teunrensing/APPS/hardware/Testapparaat/74HC14D,653.stp

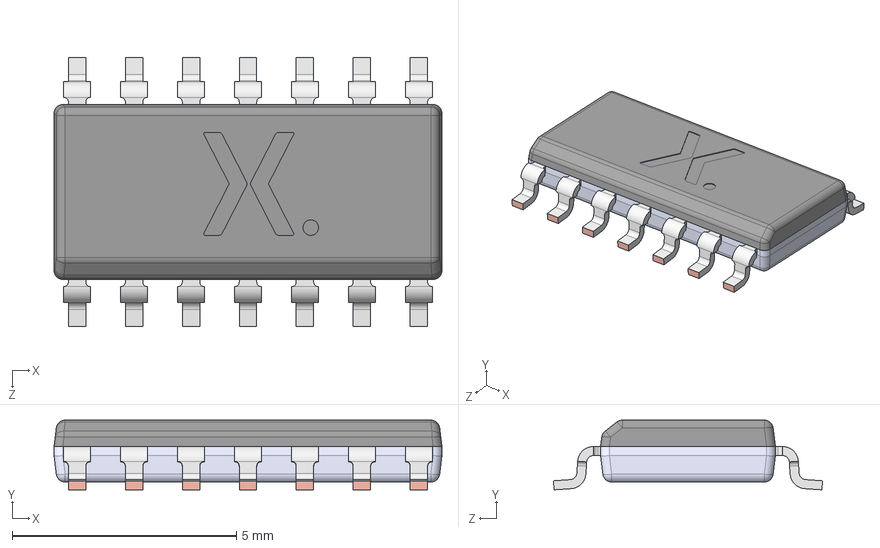
[picture p1: CAD file, 2022-11-10]
hardware/Testapparaat/74HC14D,653.stp
8.65 x 1.56 x 6.00 mm
SOT108 lower body
SOT108 upper body
SOT108-1 Lead
