teunrensing/APPS/hardware/Testapparaat/74HC595D-Q100,118/74HC595D-Q100,118.stp

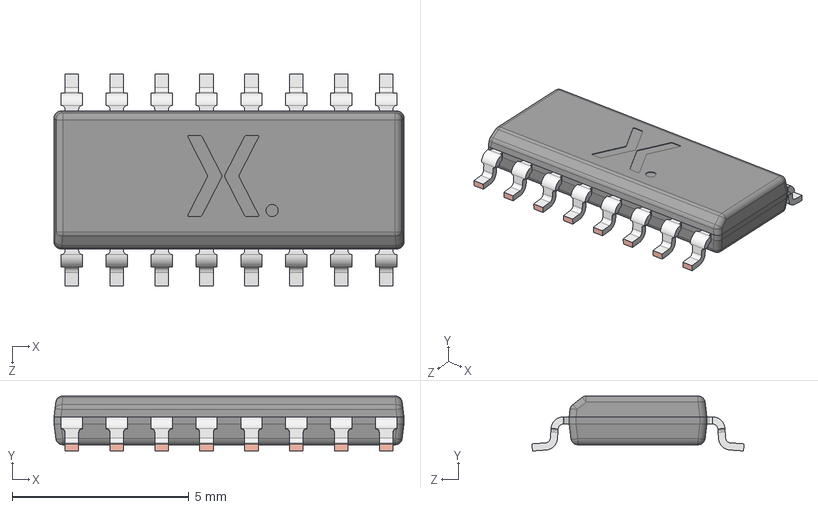
[picture p2: CAD file, 2022-11-10]
hardware/Testapparaat/74HC595D-Q100,118/74HC595D-Q100,118.stp
9.90 x 1.56 x 6.00 mm
SOT109-1 lower body
SOT109-1 upper body
SOT109-1 Lead
