teunrensing/APPS/hardware/Testapparaat/Barrel_Jack/CON-SOCJ-2155.step

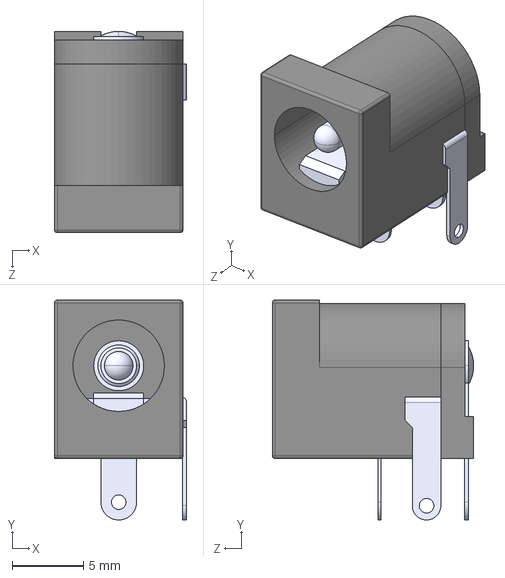
[picture p3: CAD file, 2022-10-18]
hardware/Testapparaat/Barrel_Jack/CON-SOCJ-2155.step
9.25 x 15.4 x 14.1 mm
