teunrensing/APPS/hardware/Testapparaat/F32Q-1A7H1-11040/3D/F32Q-1A7H1-11040.stp

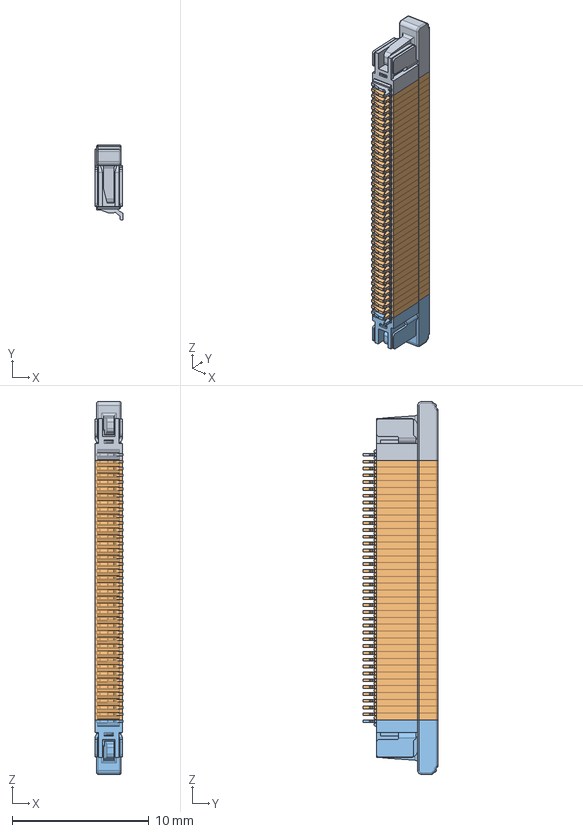
[picture p4: CAD file, 2022-11-10]
hardware/Testapparaat/F32Q-1A7H1-11040/3D/F32Q-1A7H1-11040.stp
2.05 x 5.50 x 27.3 mm
F32Q_L
F32Q_M x 38
F32Q_R
