teunrensing/APPS/hardware/Testapparaat/G17C0900132EU/D-Sub 6180xx211821.stp

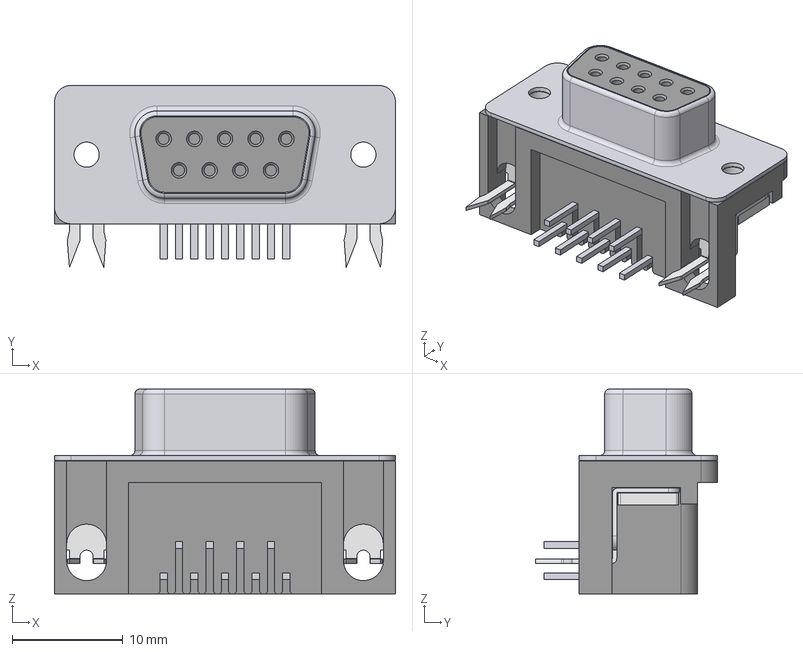
[picture p5: CAD file, 2022-10-18]
hardware/Testapparaat/G17C0900132EU/D-Sub 6180xx211821.stp
30.8 x 16.5 x 18.5 mm
