teunrensing/APPS/hardware/Testapparaat/MEM2051-00-195-00-A/MEM2051-00-195-00-A.stp

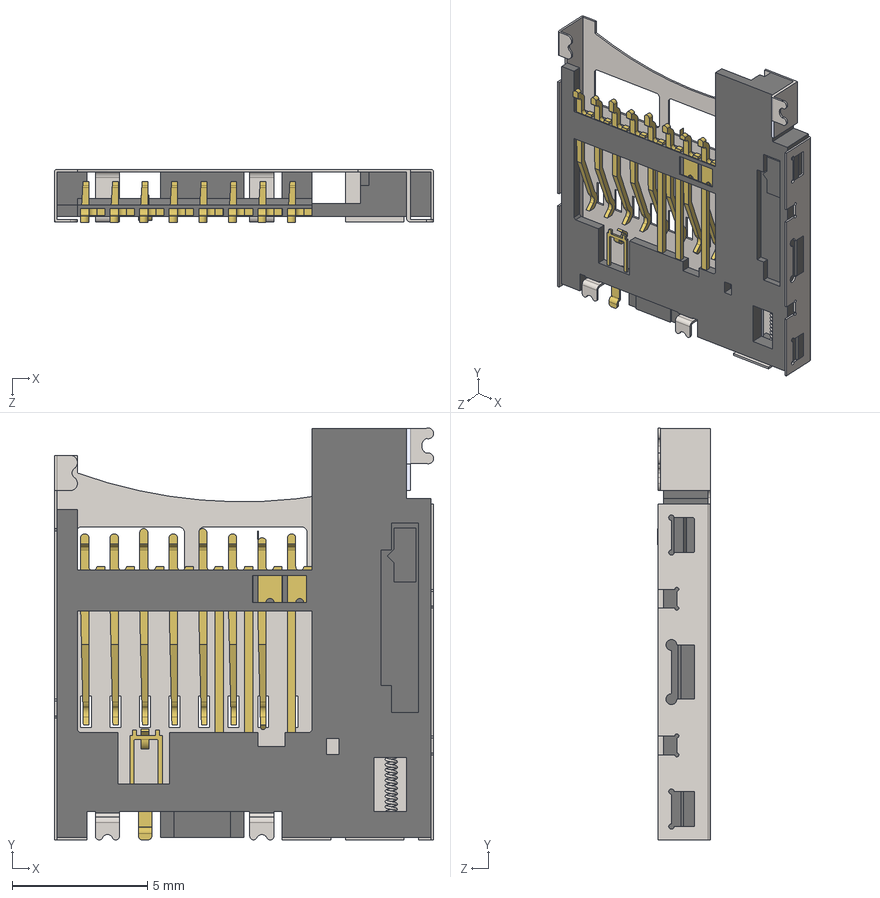
[picture p6: CAD file, 2022-10-18]
hardware/Testapparaat/MEM2051-00-195-00-A/MEM2051-00-195-00-A.stp
14.0 x 15.2 x 1.97 mm
