teunrensing/APPS/hardware/Testapparaat/SN74AHC1G02DRLR/SN74AHC1G02DRLR.stp

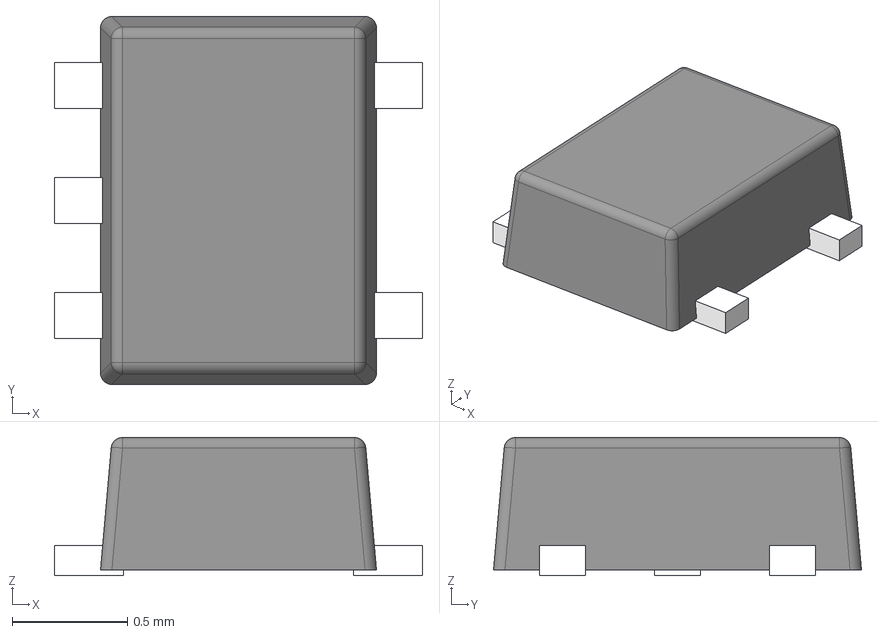
[picture p7: CAD file, 2022-10-18]
hardware/Testapparaat/SN74AHC1G02DRLR/SN74AHC1G02DRLR.stp
1.60 x 1.60 x 0.6 mm
FRAME-DRL0005A
BODY-SOT
PIN1-ID
