teunrensing/APPS/hardware/Testapparaat/SRR1260/srr1260.stp

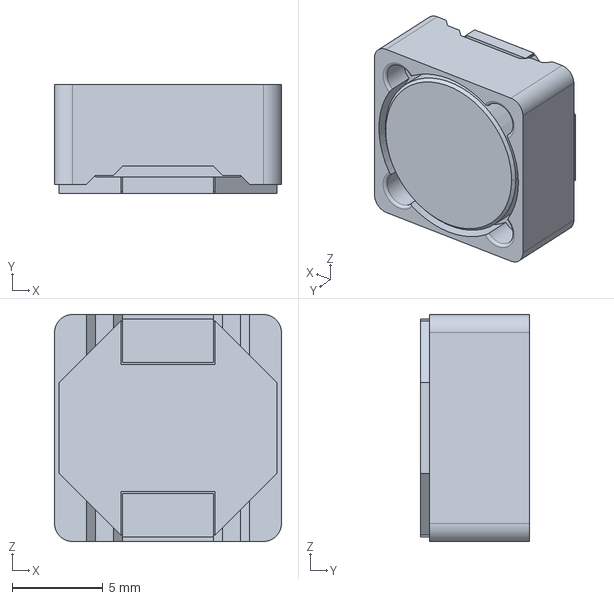
[picture p8: CAD file, 2022-11-10]
hardware/Testapparaat/SRR1260/srr1260.stp
12.5 x 6.00 x 12.5 mm
