teunrensing/APPS/hardware/Testapparaat/TCA9534PWR/TCA9534PWR.stp

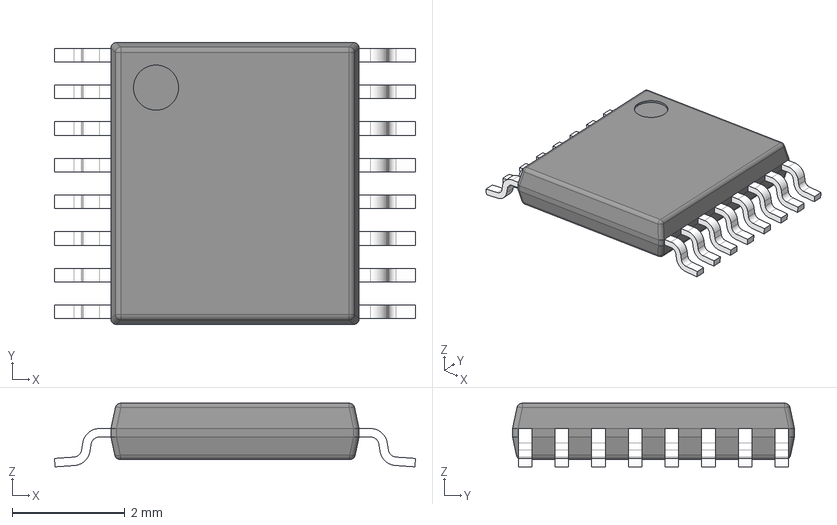
[picture p9: CAD file, 2022-11-10]
hardware/Testapparaat/TCA9534PWR/TCA9534PWR.stp
6.40 x 5.00 x 1.13 mm
BODY-TSSOP
LEAD-TSSOP x 16
PIN1
