teunrensing/APPS/hardware/Schematic/Testapparaat.pdf

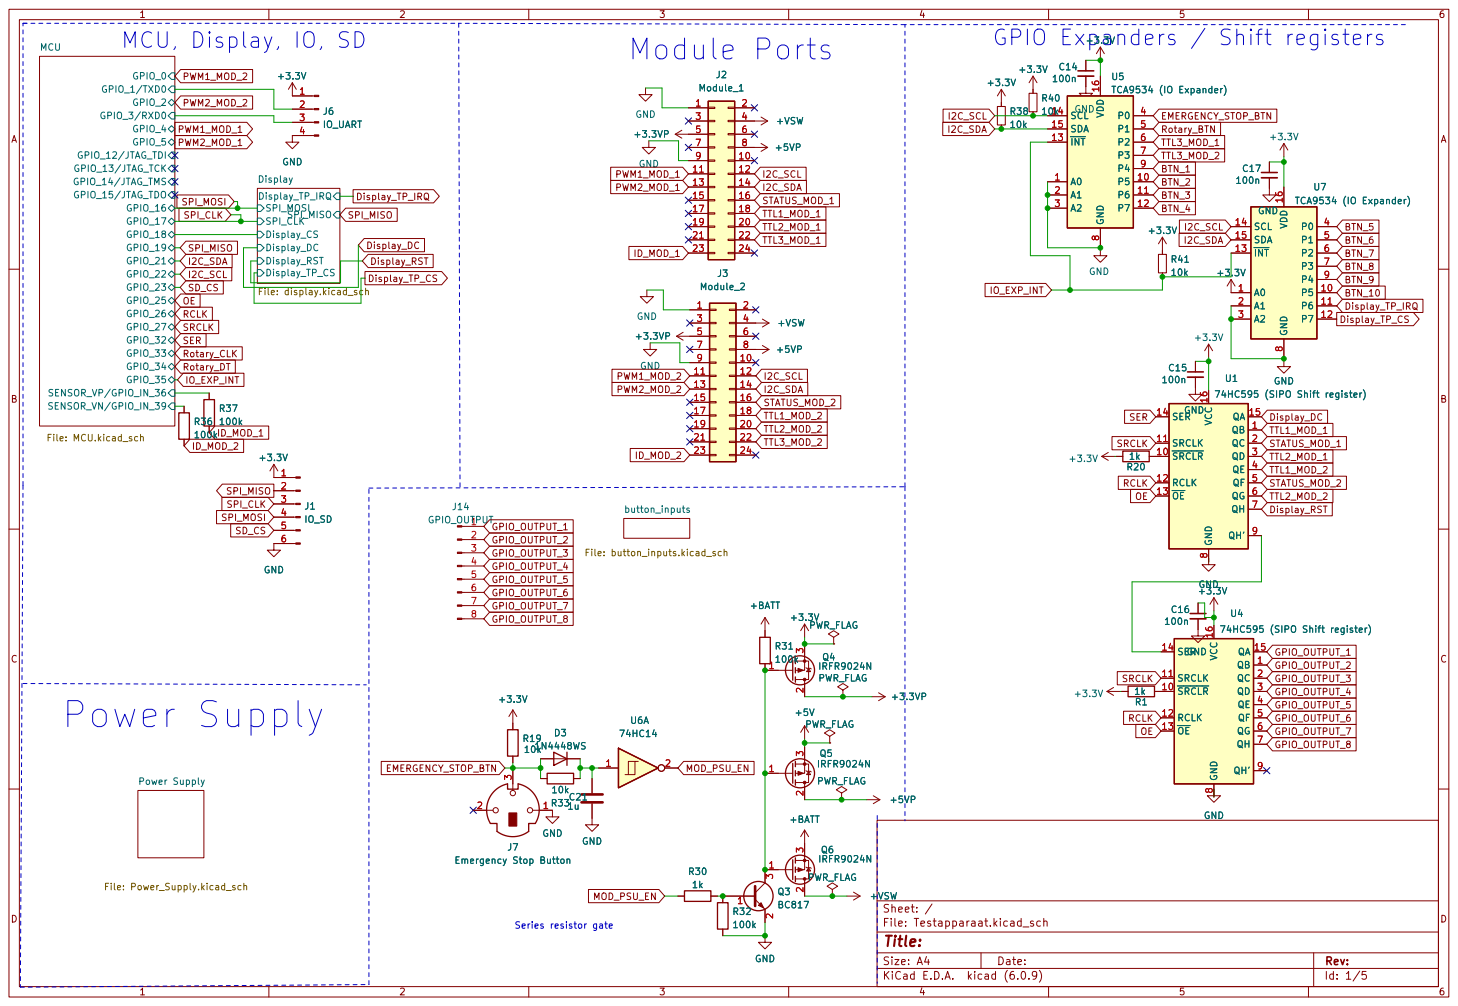
[picture p10: page 1]

GPIO Expanders / Shift registers

8 P4 9 U7 TCA9534 (IO Expander) GND GND

74HC595 (SIPO Shift register) GND

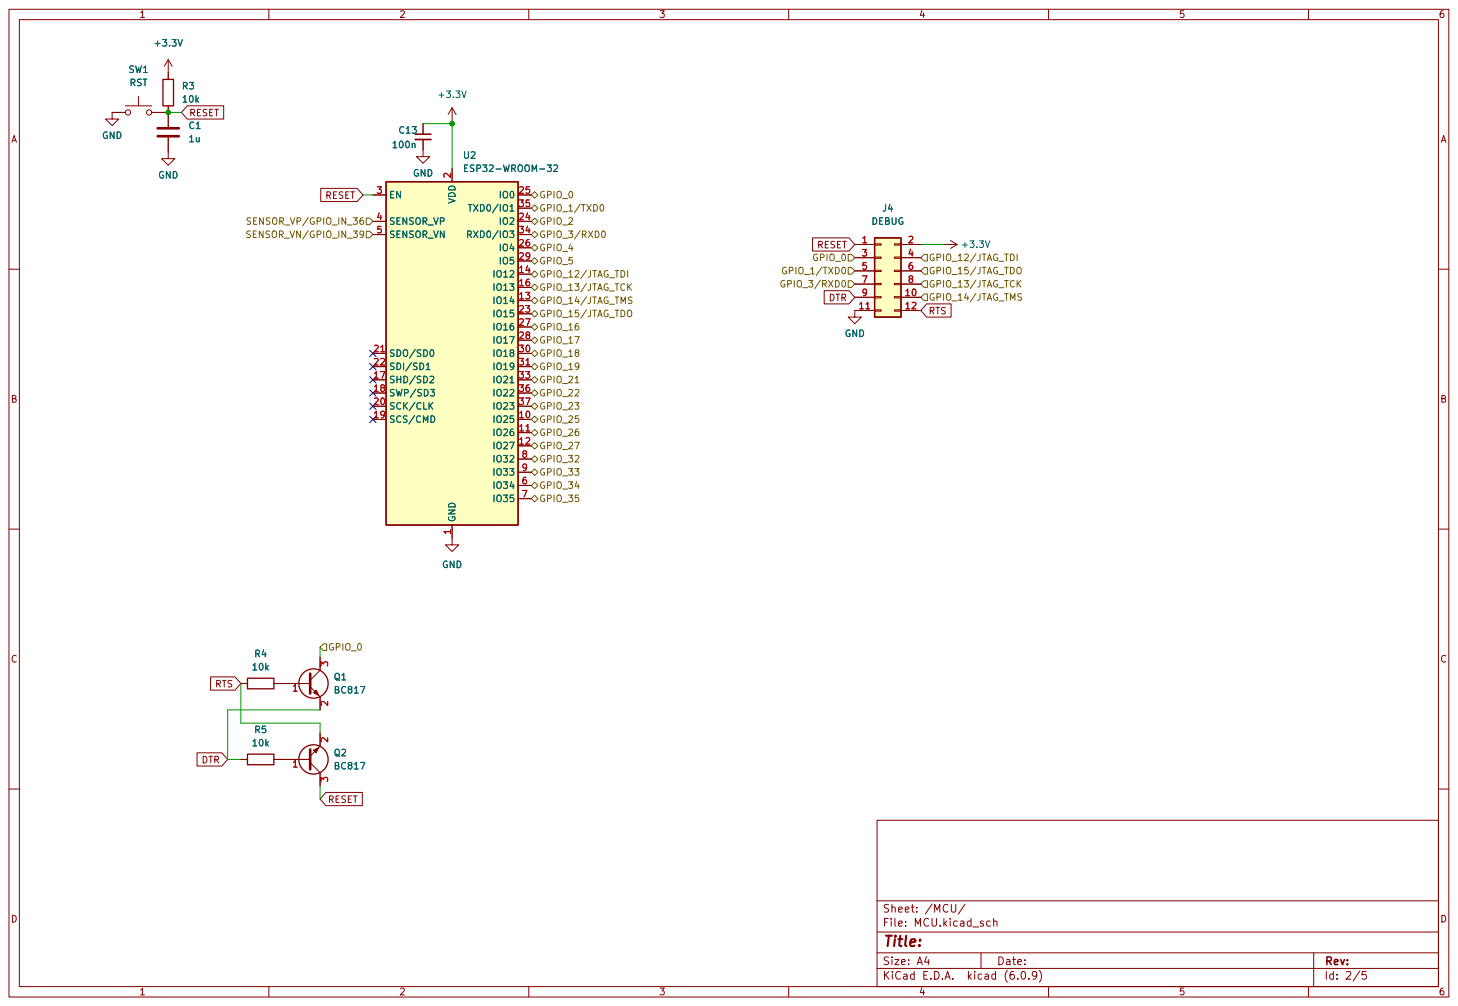
[picture p11: page 2]

RTS RESET RESETRTS DTR

File: MCU.kicad_sch Sheet: /MCU/

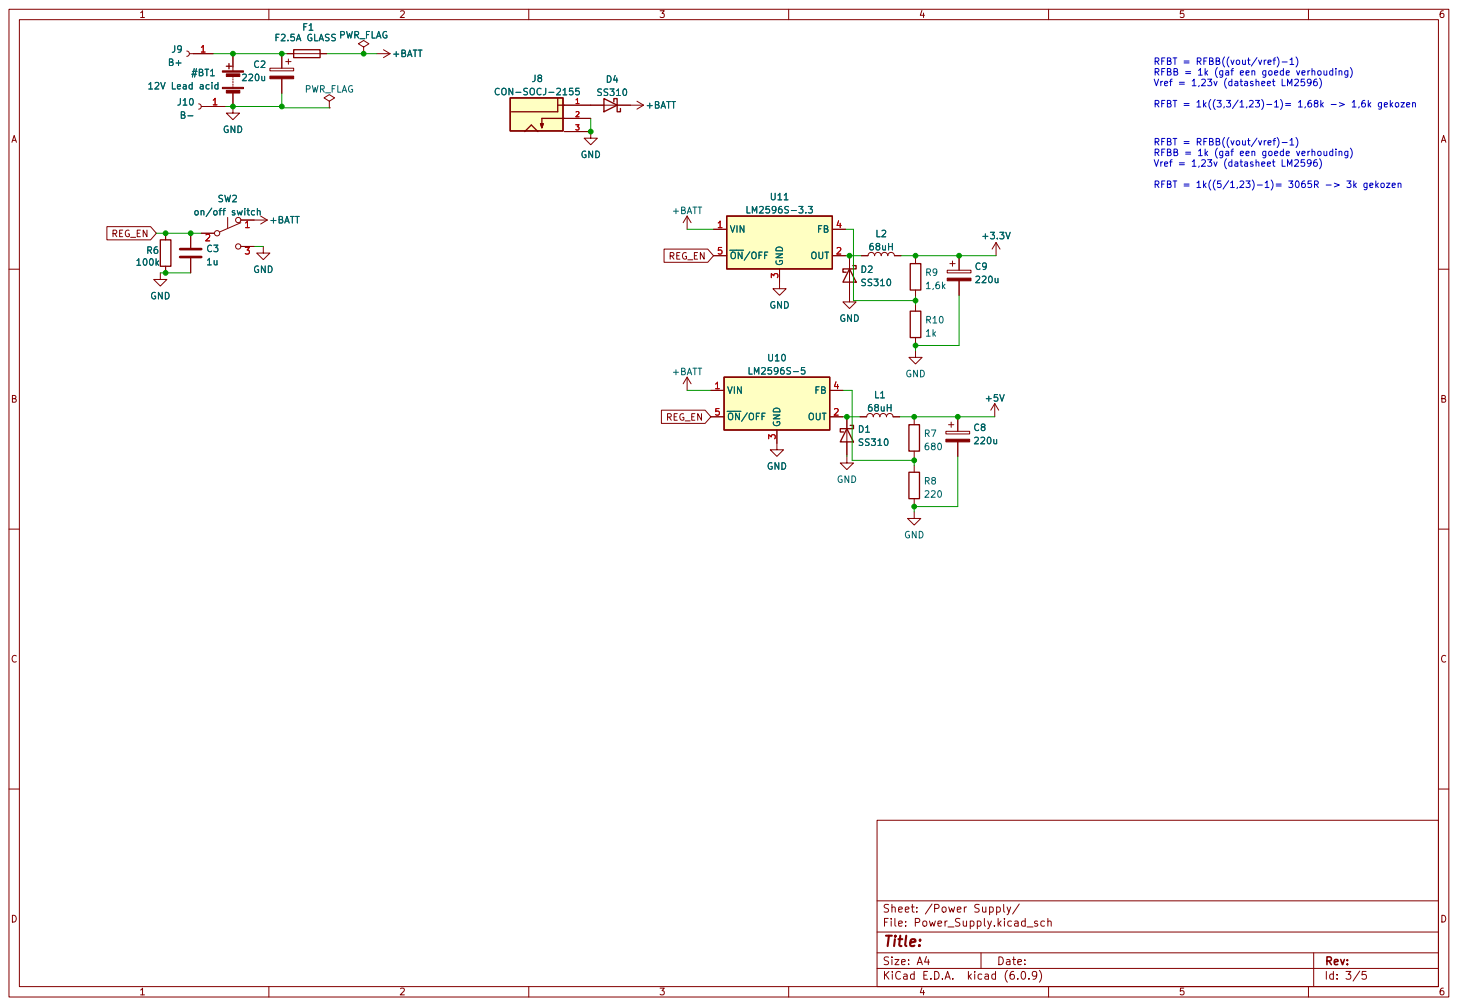
[picture p12: page 3]

RFBT = RFBB((vout/vref)-1)
RFBB = 1k (gaf een goede verhouding)
Vref = 1,23v (datasheet LM2596)

on/off switch GND

3 FB 4 ~{ON}/OFF 5 GND

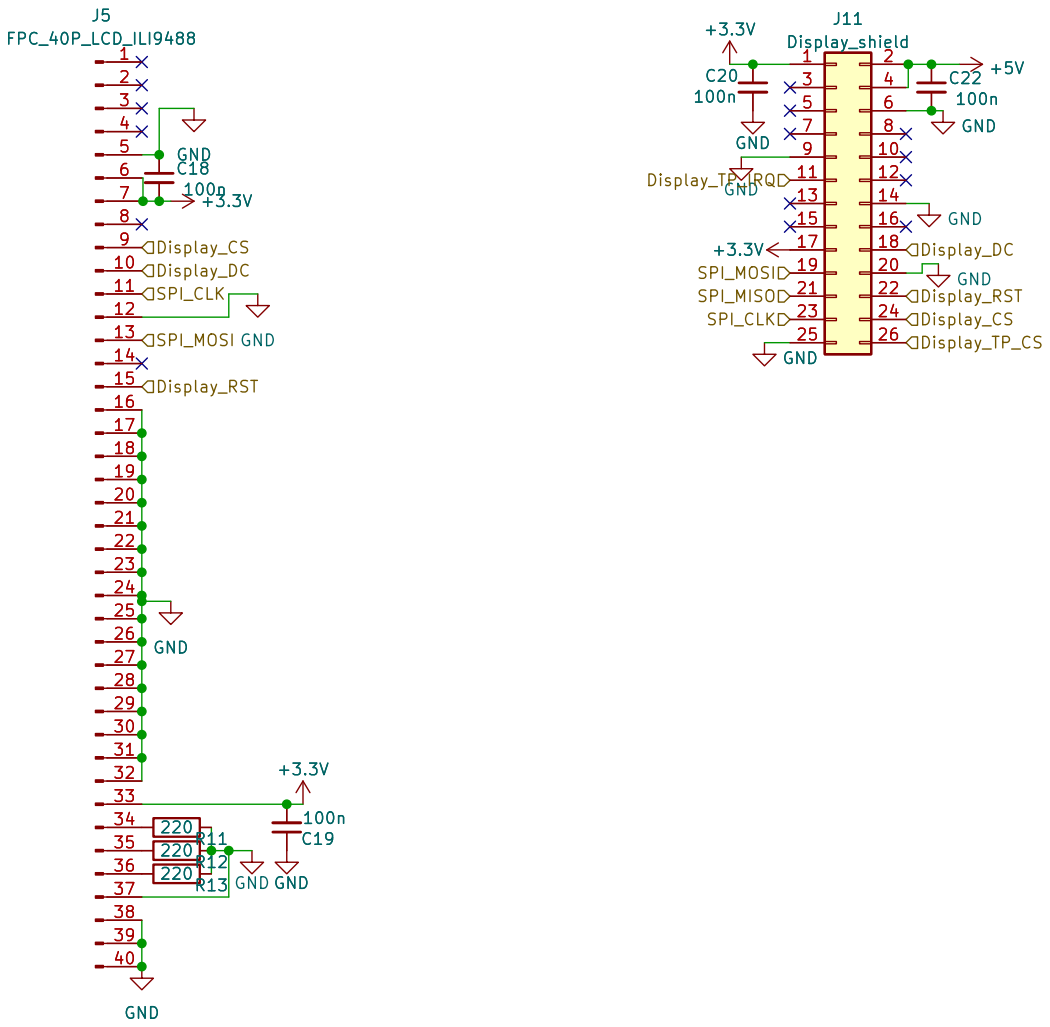
[picture p13: page 4]

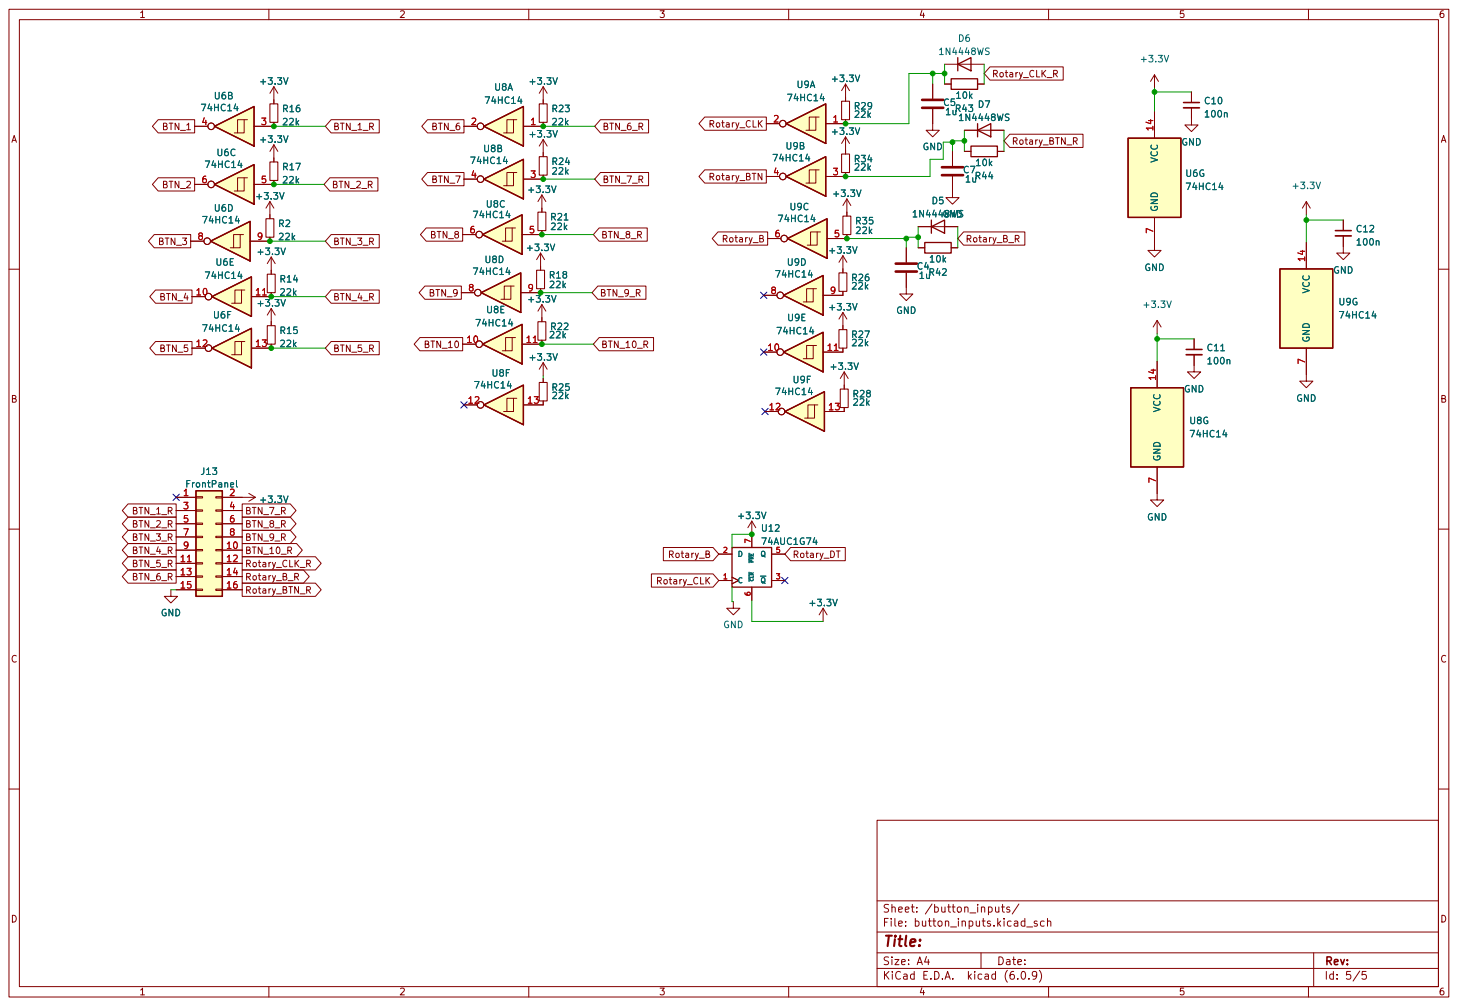
[picture p14: page 5]
