teunrensing/APPS/hardware/Testapparaat_IO/Testapparaat_io/Testapparaat_io.kicad_pcb

## KiCad design hardware/Testapparaat_IO/Testapparaat_io/Testapparaat_io.kicad_pcb (2022-11-22)

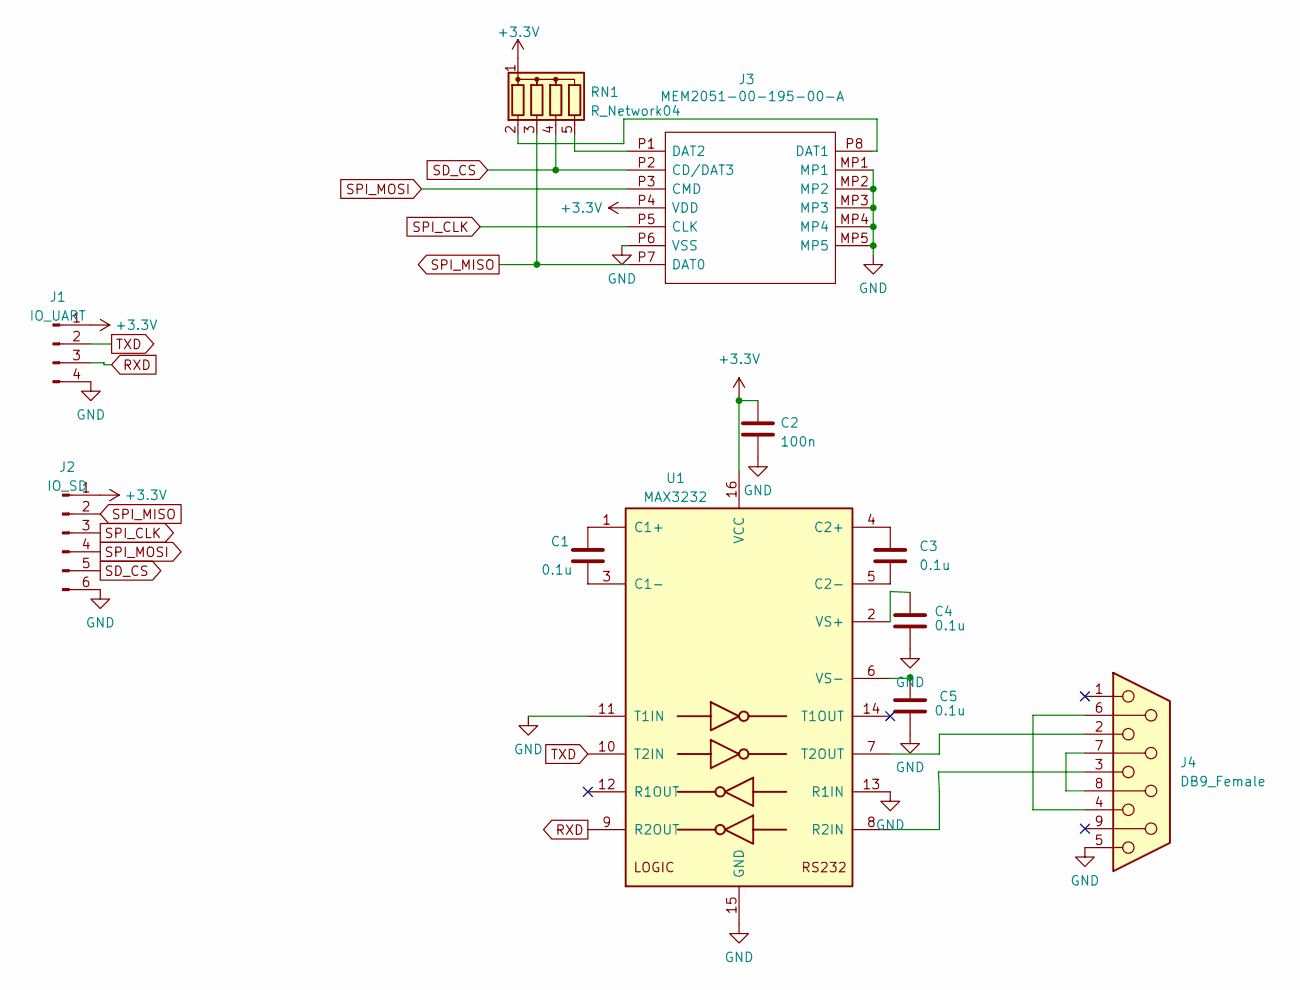
[picture p15: schematic Testapparaat_io.kicad_sch]

Parts:
C1, C3, C4, C5: 0.1u; C_0603_1608Metric_Pad1.08x0.95mm_HandSolder
C2: 100n; C_0603_1608Metric_Pad1.08x0.95mm_HandSolder
J1: IO_UART; PinHeader_1x04_P2.54mm_Horizontal
J2: IO_SD; PinHeader_1x06_P2.54mm_Horizontal
J3: MEM2051-00-195-00-A; MEM20510019500A; Manufacturer_Part_Number MEM2051-00-195-00-A; Mouser Part Number 640-MEM20510019500A
J4: DB9_Female; G17C0900132EU
RN1: R_Network04; R_Array_SIP5
U1: MAX3232; TSSOP-16_4.4x5mm_P0.65mm

Connections:
+3.3V: C2.1, J1.1, J2.1, J3.P4 (VDD), RN1.1 (common), U1.16 (VCC)
GND: C2.2, C4.1, C5.2, J1.4, J2.6, J3.MP1, J3.MP2, J3.MP3, J3.MP4, J3.MP5, J3.P6 (VSS), J4.5, U1.11 (T1IN), U1.13 (R1IN), U1.15 (GND)
unnamed: C1.1, U1.1 (C1+)
unnamed: C1.2, U1.3 (C1-)
unnamed: C3.1, U1.4 (C2+)
unnamed: C3.2, U1.5 (C2-)
unnamed: C4.2, U1.2 (VS+)
unnamed: C5.1, U1.6 (VS-)
unnamed: J3.P8 (DAT1), RN1.2 (R1)
unnamed: J4.2, U1.7 (T2OUT)
unnamed: J4.3, U1.8 (R2IN)
unnamed: J4.4, J4.6
unnamed: J4.7, J4.8
unnamed: J3.P1 (DAT2), RN1.5 (R4)
RXD: J1.3, U1.9 (R2OUT)
SD_CS: J2.5, J3.P2 (CD/DAT3), RN1.4 (R3)
SPI_CLK: J2.3, J3.P5 (CLK)
SPI_MISO: J2.2, J3.P7 (DAT0), RN1.3 (R2)
SPI_MOSI: J2.4, J3.P3 (CMD)
TXD: J1.2, U1.10 (T2IN)

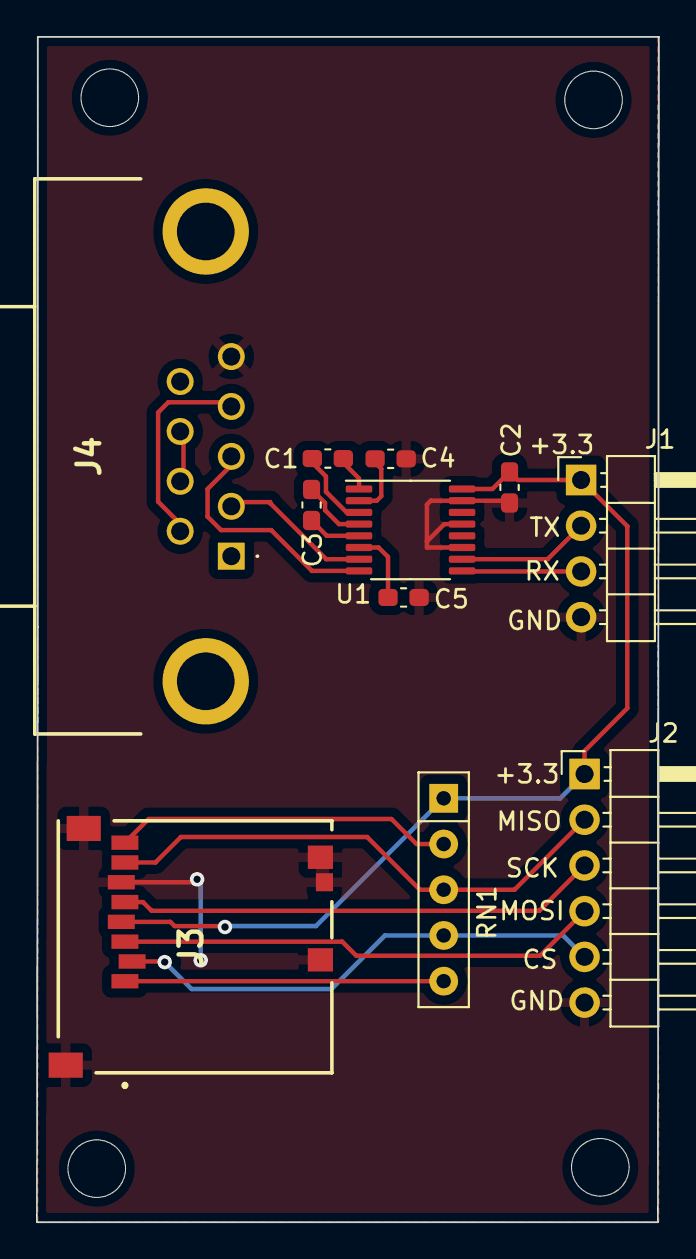
[picture p16: board Testapparaat_io.kicad_pcb from above]

Board: 2 copper layers, 34.5 x 65.8 mm, 11 parts (0 on the bottom side), 20 nets.
