teunrensing/APPS/hardware/Testapparaat/Testapparaat.kicad_pcb

## KiCad design hardware/Testapparaat/Testapparaat.kicad_pcb (2022-11-22)

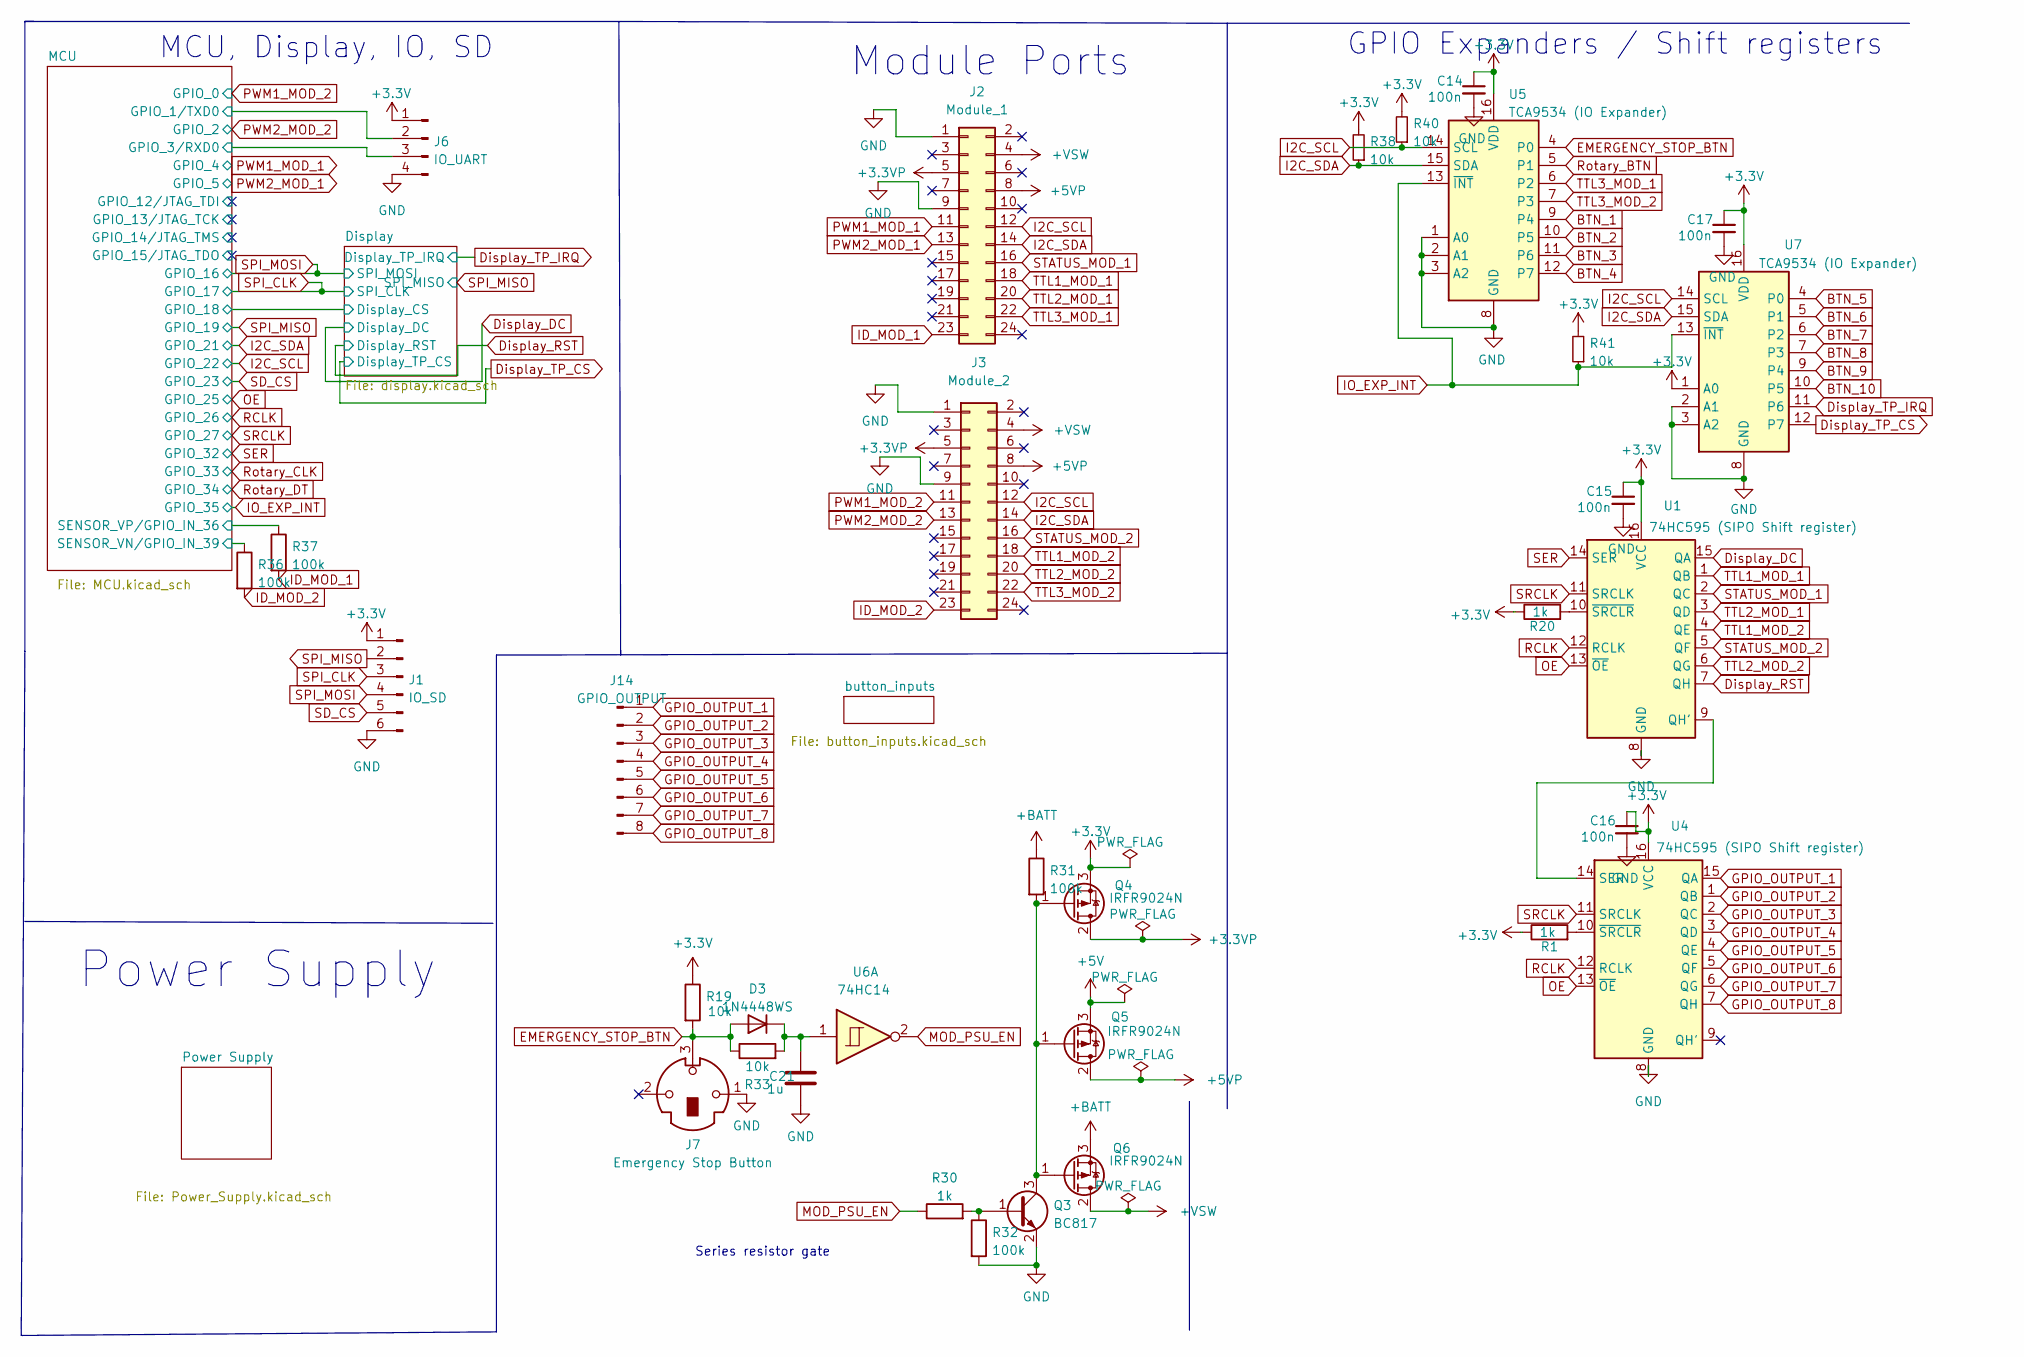
[picture p17: schematic Testapparaat.kicad_sch]

Parts:
C14, C15, C16, C17: 100n; C_0603_1608Metric_Pad1.08x0.95mm_HandSolder
C21: 1u; C_0603_1608Metric_Pad1.08x0.95mm_HandSolder
D3: 1N4448WS; D_SOD-323
J1: IO_SD; PinHeader_1x06_P2.54mm_Horizontal
J2: Module_1; PinHeader_2x12_P2.54mm_Horizontal
J3: Module_2; PinHeader_2x12_P2.54mm_Horizontal
J6: IO_UART; PinHeader_1x04_P2.54mm_Horizontal
J7: Emergency Stop Button; PinHeader_1x03_P2.54mm_Horizontal
J14: GPIO_OUTPUT; PinHeader_2x04_P2.54mm_Vertical_SMD
Q3: BC817; SOT-23
Q4, Q5, Q6: IRFR9024N; TO-252-3_TabPin2
R1, R20, R30: 1k; R_0603_1608Metric_Pad0.98x0.95mm_HandSolder
R19, R33, R38, R40, R41: 10k; R_0603_1608Metric_Pad0.98x0.95mm_HandSolder
R31, R32, R36, R37: 100k; R_0603_1608Metric_Pad0.98x0.95mm_HandSolder
U1, U4: 74HC595 (SIPO Shift register); 74HC595DQ100118
U5, U7: TCA9534 (IO Expander); SOP65P640X120-16N
U6: 74HC14; SO-14_3.9x8.65mm_P1.27mm

Connections:
+3.3V: C14.1, C15.1, C16.1, C17.1, J1.1, J6.1, Q4.3 (S), R1.1, R19.1, R20.1, R38.2, R40.2, R41.2, U1.16 (VCC), U4.16 (VCC), U5.16 (VDD), U7.1 (A0), U7.16 (VDD); also elsewhere on the board
+3.3VP: J2.5, J3.5, Q4.2 (D)
+5V: Q5.3 (S); also elsewhere on the board
+5VP: J2.8, J3.8, Q5.2 (D)
+BATT: Q6.3 (S), R31.1; also elsewhere on the board
+VSW: J2.4, J3.4, Q6.2 (D)
/MCU/GPIO_1/TXD0: J6.2; also elsewhere on the board
/MCU/GPIO_3/RXD0: J6.3; also elsewhere on the board
/MCU/SENSOR_VN/GPIO_IN_39: R36.1; also elsewhere on the board
/MCU/SENSOR_VP/GPIO_IN_36: R37.1; also elsewhere on the board
BTN_1: U5.9 (P4); also elsewhere on the board
BTN_2: U5.10 (P5); also elsewhere on the board
BTN_3: U5.11 (P6); also elsewhere on the board
BTN_4: U5.12 (P7); also elsewhere on the board
BTN_5: U7.4 (P0); also elsewhere on the board
BTN_6: U7.5 (P1); also elsewhere on the board
BTN_7: U7.6 (P2); also elsewhere on the board
BTN_8: U7.7 (P3); also elsewhere on the board
BTN_9: U7.9 (P4); also elsewhere on the board
BTN_10: U7.10 (P5); also elsewhere on the board
Display_DC: U1.15 (QA); also elsewhere on the board
Display_RST: U1.7 (QH); also elsewhere on the board
Display_TP_CS: U7.12 (P7); also elsewhere on the board
Display_TP_IRQ: U7.11 (P6); also elsewhere on the board
EMERGENCY_STOP_BTN: D3.2 (A), J7.3, R19.2, R33.1, U5.4 (P0)
GPIO_OUTPUT_1: J14.1, U4.15 (QA)
GPIO_OUTPUT_2: J14.2, U4.1 (QB)
GPIO_OUTPUT_3: J14.3, U4.2 (QC)
GPIO_OUTPUT_4: J14.4, U4.3 (QD)
GPIO_OUTPUT_5: J14.5, U4.4 (QE)
GPIO_OUTPUT_6: J14.6, U4.5 (QF)
GPIO_OUTPUT_7: J14.7, U4.6 (QG)
GPIO_OUTPUT_8: J14.8, U4.7 (QH)
I2C_SCL: J2.12, J3.12, R40.1, U5.14 (SCL), U7.14 (SCL); also elsewhere on the board
I2C_SDA: J2.14, J3.14, R38.1, U5.15 (SDA), U7.15 (SDA); also elsewhere on the board
ID_MOD_1: J2.23, R37.2
ID_MOD_2: J3.23, R36.2
IO_EXP_INT: R41.1, U5.13 (~INT), U7.13 (~INT); also elsewhere on the board
MOD_PSU_EN: R30.1, U6.2
unnamed: C21.1, D3.1 (K), R33.2, U6.1
unnamed: Q3.1 (B), R30.2, R32.1
unnamed: Q3.3 (C), Q4.1 (G), Q5.1 (G), Q6.1 (G), R31.2
unnamed: R1.2, U4.10 (~SRCLR)
unnamed: R20.2, U1.10 (~SRCLR)
unnamed: U1.9 (QH'), U4.14 (SER)
OE: U1.13 (~OE), U4.13 (~OE); also elsewhere on the board
PWM1_MOD_1: J2.11; also elsewhere on the board
PWM1_MOD_2: J3.11; also elsewhere on the board
PWM2_MOD_1: J2.13; also elsewhere on the board
PWM2_MOD_2: J3.13; also elsewhere on the board
RCLK: U1.12 (RCLK), U4.12 (RCLK); also elsewhere on the board
Rotary_BTN: U5.5 (P1); also elsewhere on the board
SD_CS: J1.5; also elsewhere on the board
SER: U1.14 (SER); also elsewhere on the board
SPI_CLK: J1.3; also elsewhere on the board
SPI_MISO: J1.2; also elsewhere on the board
SPI_MOSI: J1.4; also elsewhere on the board
SRCLK: U1.11 (SRCLK), U4.11 (SRCLK); also elsewhere on the board
STATUS_MOD_1: J2.16, U1.2 (QC)
STATUS_MOD_2: J3.16, U1.5 (QF)
TTL1_MOD_1: J2.18, U1.1 (QB)
TTL1_MOD_2: J3.18, U1.4 (QE)
TTL2_MOD_1: J2.20, U1.3 (QD)
TTL2_MOD_2: J3.20, U1.6 (QG)
TTL3_MOD_1: J2.22, U5.6 (P2)
TTL3_MOD_2: J3.22, U5.7 (P3)

Notes on the sheet:
MCU, Display, IO, SD
Series resistor gate
GPIO Expanders / Shift registers
Power Supply
Module Ports

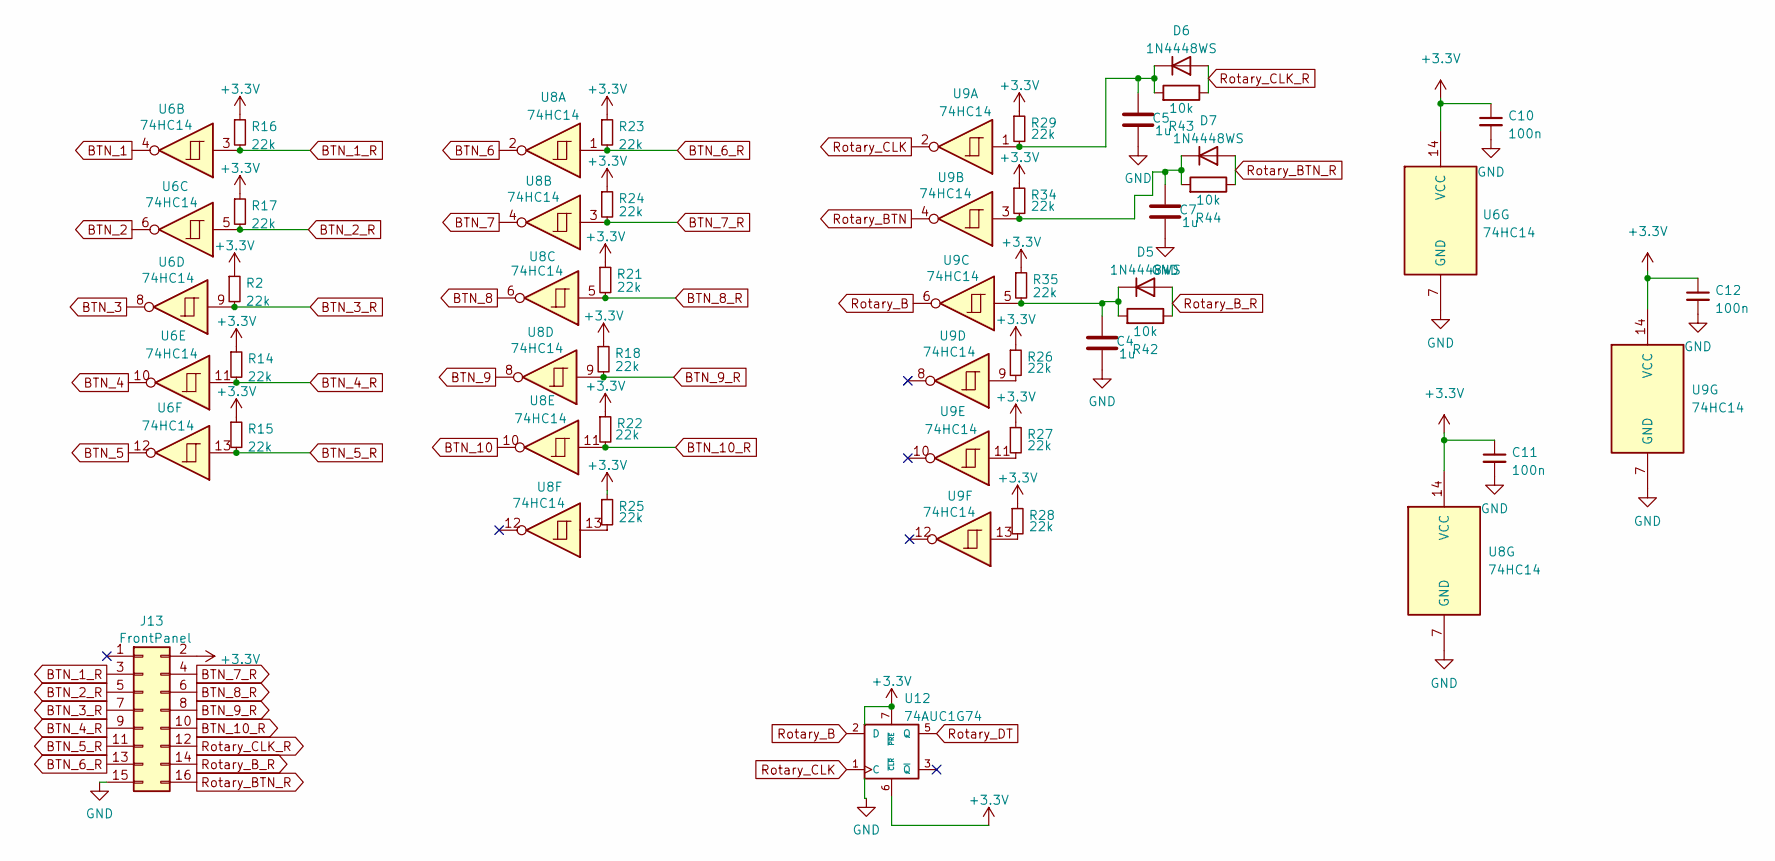
[picture p18: schematic button_inputs.kicad_sch]

Parts:
C4, C5, C7: 1u; C_0603_1608Metric_Pad1.08x0.95mm_HandSolder
C10, C11, C12: 100n; C_0603_1608Metric_Pad1.08x0.95mm_HandSolder
D5, D6, D7: 1N4448WS; D_SOD-323
J13: FrontPanel; PinHeader_2x08_P2.54mm_Vertical_SMD
R2, R14, R15, R16, R17, R18, R21, R22, R23, R24, R25, R26, R27, R28, R29, R34, R35: 22k; R_0603_1608Metric_Pad0.98x0.95mm_HandSolder
R42, R43, R44: 10k; R_0603_1608Metric_Pad0.98x0.95mm_HandSolder
U6, U8, U9: 74HC14; SO-14_3.9x8.65mm_P1.27mm
U12: 74AUC1G74; VSSOP-8_2.3x2mm_P0.5mm

Connections:
+3.3V: C10.1, C11.1, C12.1, J13.2, R2.1, R14.1, R15.1, R16.1, R17.1, R18.1, R21.1, R22.1, R23.1, R24.1, R25.1, R26.1, R27.1, R28.1, R29.1, R34.1, R35.1, U6.14 (VCC), U8.14 (VCC), U9.14 (VCC), U12.6 (~CLR), U12.7 (~PRE), U12.8 (VCC); also elsewhere on the board
BTN_1: U6.4; also elsewhere on the board
BTN_1_R: J13.3, R16.2, U6.3
BTN_2: U6.6; also elsewhere on the board
BTN_2_R: J13.5, R17.2, U6.5
BTN_3: U6.8; also elsewhere on the board
BTN_3_R: J13.7, R2.2, U6.9
BTN_4: U6.10; also elsewhere on the board
BTN_4_R: J13.9, R14.2, U6.11
BTN_5: U6.12; also elsewhere on the board
BTN_5_R: J13.11, R15.2, U6.13
BTN_6: U8.2; also elsewhere on the board
BTN_6_R: J13.13, R23.2, U8.1
BTN_7: U8.4; also elsewhere on the board
BTN_7_R: J13.4, R24.2, U8.3
BTN_8: U8.6; also elsewhere on the board
BTN_8_R: J13.6, R21.2, U8.5
BTN_9: U8.8; also elsewhere on the board
BTN_9_R: J13.8, R18.2, U8.9
BTN_10: U8.10; also elsewhere on the board
BTN_10_R: J13.10, R22.2, U8.11
unnamed: C4.1, D5.1 (K), R35.2, R42.2, U9.5
unnamed: C5.1, D6.1 (K), R29.2, R43.2, U9.1
unnamed: C7.1, D7.1 (K), R34.2, R44.2, U9.3
unnamed: R25.2, U8.13
unnamed: R26.2, U9.9
unnamed: R27.2, U9.11
unnamed: R28.2, U9.13
Rotary_B: U9.6, U12.2 (D)
Rotary_BTN: U9.4; also elsewhere on the board
Rotary_BTN_R: D7.2 (A), J13.16, R44.1
Rotary_B_R: D5.2 (A), J13.14, R42.1
Rotary_CLK: U9.2, U12.1 (C); also elsewhere on the board
Rotary_CLK_R: D6.2 (A), J13.12, R43.1
Rotary_DT: U12.5 (Q); also elsewhere on the board

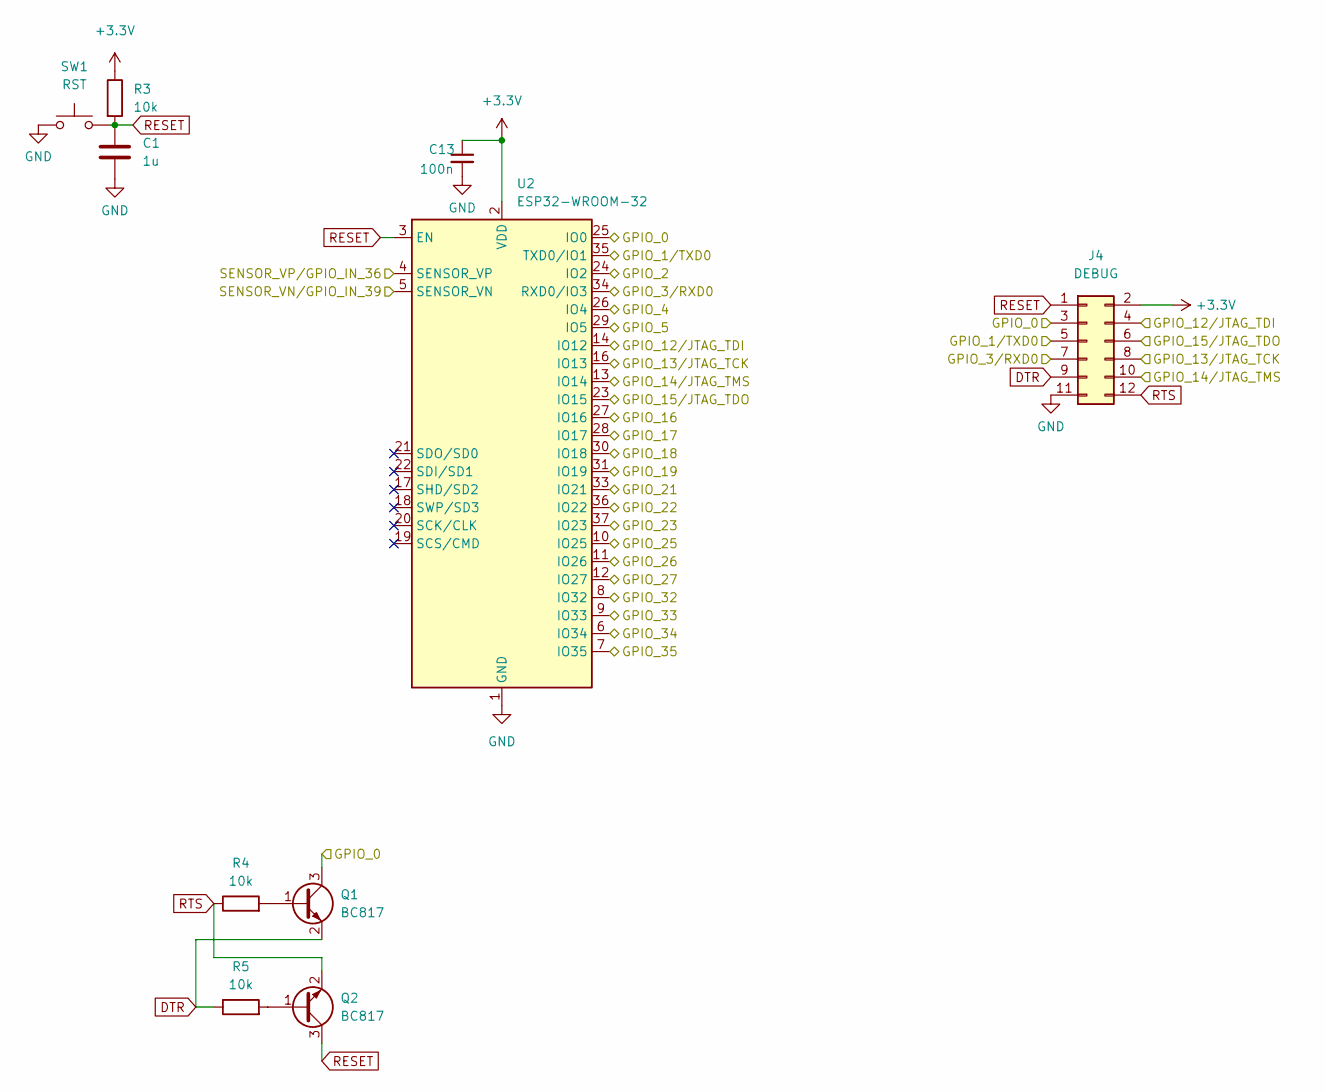
[picture p19: schematic MCU.kicad_sch]

Parts:
C1: 1u; C_0603_1608Metric_Pad1.08x0.95mm_HandSolder
C13: 100n; C_0603_1608Metric_Pad1.08x0.95mm_HandSolder
J4: DEBUG; PinHeader_2x06_P2.54mm_Vertical_SMD
Q1, Q2: BC817; SOT-23
R3, R4, R5: 10k; R_0603_1608Metric_Pad0.98x0.95mm_HandSolder
SW1: RST; SW_SPST_B3S-1000
U2: ESP32-WROOM-32

Connections:
+3.3V: C13.1, J4.2, R3.1, U2.2 (VDD); also elsewhere on the board
/Display/Display_CS: U2.30 (IO18); also elsewhere on the board
/MCU/GPIO_1/TXD0: J4.5, U2.35 (TXD0/IO1); also elsewhere on the board
/MCU/GPIO_3/RXD0: J4.7, U2.34 (RXD0/IO3); also elsewhere on the board
/MCU/GPIO_12/JTAG_TDI: J4.4, U2.14 (IO12)
/MCU/GPIO_13/JTAG_TCK: J4.8, U2.16 (IO13)
/MCU/GPIO_14/JTAG_TMS: J4.10, U2.13 (IO14)
/MCU/GPIO_15/JTAG_TDO: J4.6, U2.23 (IO15)
/MCU/SENSOR_VN/GPIO_IN_39: U2.5 (SENSOR_VN); also elsewhere on the board
/MCU/SENSOR_VP/GPIO_IN_36: U2.4 (SENSOR_VP); also elsewhere on the board
DTR: J4.9, Q1.2 (E), R5.1
I2C_SCL: U2.36 (IO22); also elsewhere on the board
I2C_SDA: U2.33 (IO21); also elsewhere on the board
IO_EXP_INT: U2.7 (IO35); also elsewhere on the board
unnamed: Q1.1 (B), R4.2
unnamed: Q2.1 (B), R5.2
OE: U2.10 (IO25); also elsewhere on the board
PWM1_MOD_1: U2.26 (IO4); also elsewhere on the board
PWM1_MOD_2: J4.3, Q1.3 (C), U2.25 (IO0); also elsewhere on the board
PWM2_MOD_1: U2.29 (IO5); also elsewhere on the board
PWM2_MOD_2: U2.24 (IO2); also elsewhere on the board
RCLK: U2.11 (IO26); also elsewhere on the board
RESET: C1.1, J4.1, Q2.3 (C), R3.2, SW1.2, U2.3 (EN)
RTS: J4.12, Q2.2 (E), R4.1
Rotary_CLK: U2.9 (IO33); also elsewhere on the board
Rotary_DT: U2.6 (IO34); also elsewhere on the board
SD_CS: U2.37 (IO23); also elsewhere on the board
SER: U2.8 (IO32); also elsewhere on the board
SPI_CLK: U2.28 (IO17); also elsewhere on the board
SPI_MISO: U2.31 (IO19); also elsewhere on the board
SPI_MOSI: U2.27 (IO16); also elsewhere on the board
SRCLK: U2.12 (IO27); also elsewhere on the board

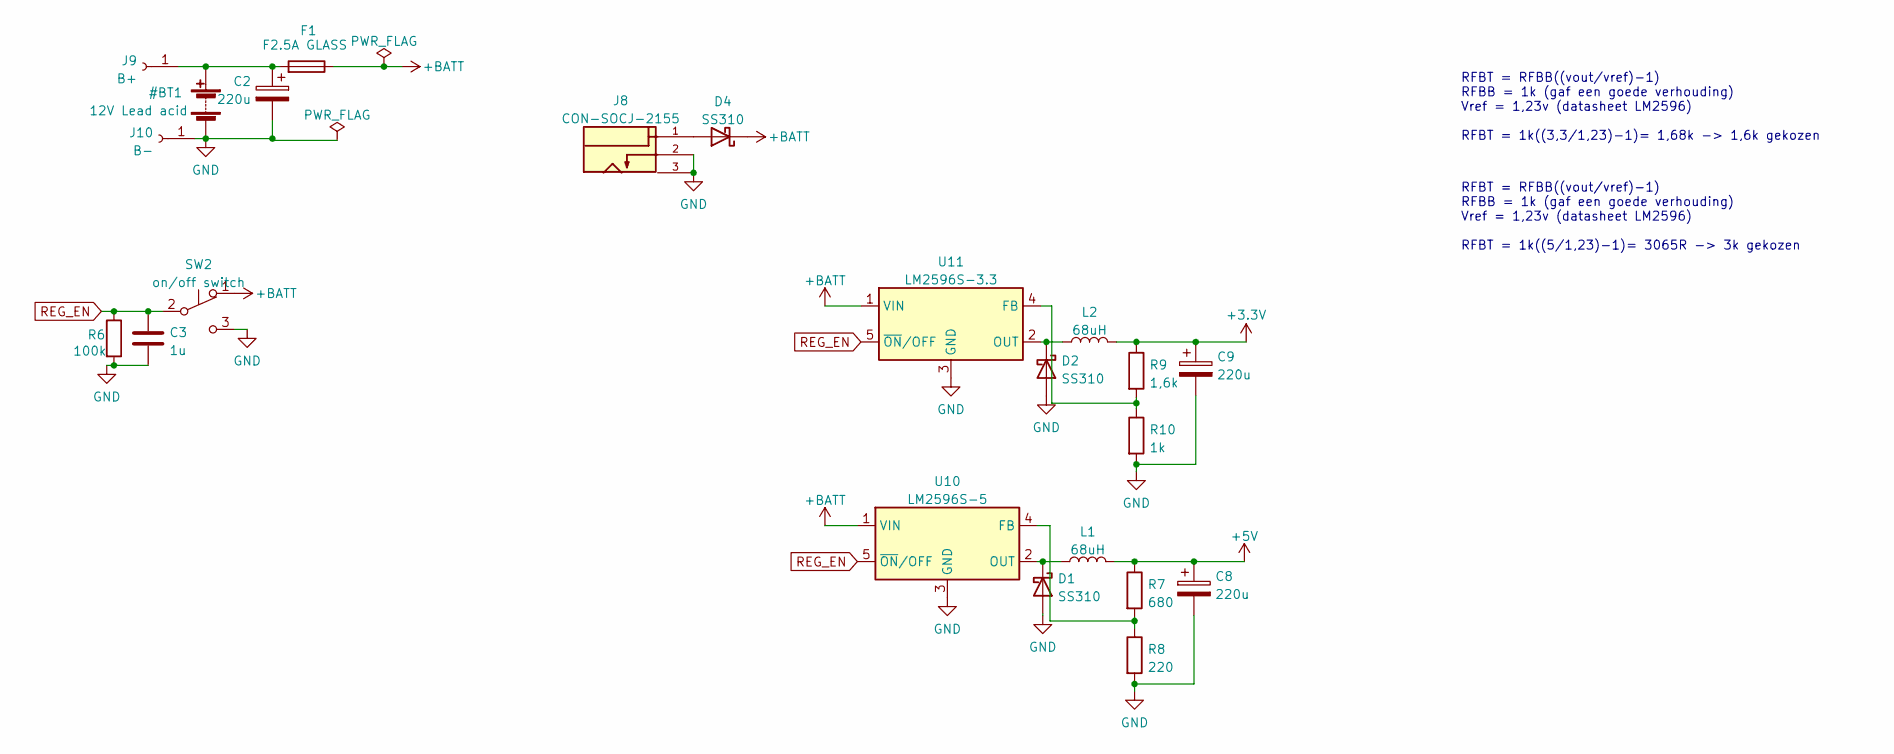
[picture p20: schematic Power_Supply.kicad_sch]

Parts:
C2, C8, C9: 220u; C_Radial_D10.0mm_H12.5mm_P5.00mm
C3: 1u; C_0603_1608Metric_Pad1.08x0.95mm_HandSolder
D1, D2, D4: SS310; D_SMA_Handsoldering
F1: F2.5A GLASS; Fuseholder_Littelfuse_100_series_5x20mm
J8: CON-SOCJ-2155; GRAVITECH_CON-SOCJ-2155; PARTREV NA
J9: B+; TestPoint_Plated_Hole_D2.0mm
J10: B-; TestPoint_Plated_Hole_D2.0mm
L1, L2: 68uH; L_Bourns_SRR1260
R6: 100k; R_0603_1608Metric_Pad0.98x0.95mm_HandSolder
R7: 680; R_0603_1608Metric_Pad0.98x0.95mm_HandSolder
R8: 220; R_0603_1608Metric_Pad0.98x0.95mm_HandSolder
R9: 1,6k; R_0603_1608Metric_Pad0.98x0.95mm_HandSolder
R10: 1k; R_0603_1608Metric_Pad0.98x0.95mm_HandSolder
SW2: on/off switch; SW_Slide_1P2T_CK_OS102011MS2Q
U10: LM2596S-5; TO-263-5_TabPin3
U11: LM2596S-3.3; TO-263-5_TabPin3

Connections:
+3.3V: C9.1, L2.2, R9.1; also elsewhere on the board
+5V: C8.1, L1.2, R7.1; also elsewhere on the board
+BATT: D4.1 (K), F1.1, SW2.1 (A), U10.1 (VIN), U11.1 (VIN); also elsewhere on the board
unnamed: D1.1 (K), L1.1, U10.2 (OUT)
unnamed: D2.1 (K), L2.1, U11.2 (OUT)
unnamed: D4.2 (A), J8.1
unnamed: R7.2, R8.1, U10.4 (FB)
unnamed: R9.2, R10.1, U11.4 (FB)
REG_EN: C3.1, R6.1, SW2.2 (B), U10.5 (~ON/OFF), U11.5 (~ON/OFF)

Notes on the sheet:
RFBT = RFBB((vout/vref)-1) RFBB = 1k (gaf een goede verhouding) Vref = 1,23v (datasheet LM2596) RFBT = 1k((5/1,23)-1)= 3065R -> 3k gekozen
RFBT = RFBB((vout/vref)-1) RFBB = 1k (gaf een goede verhouding) Vref = 1,23v (datasheet LM2596) RFBT = 1k((3,3/1,23)-1)= 1,68k -> 1,6k gekozen

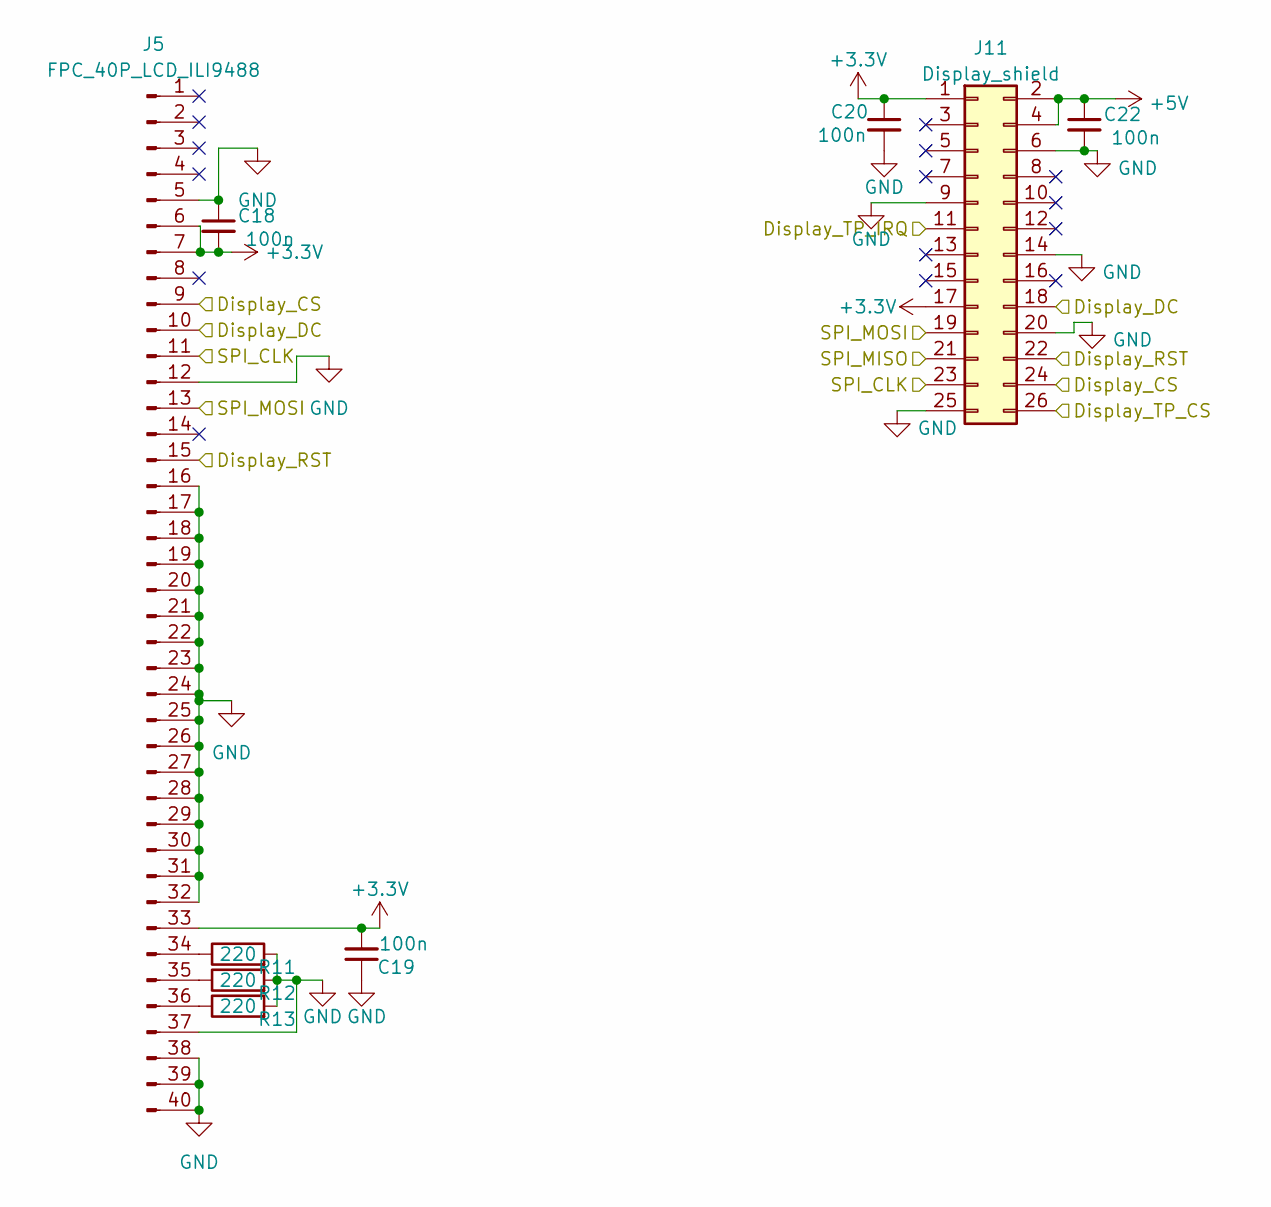
[picture p21: schematic display.kicad_sch]

Parts:
C18, C19, C20, C22: 100n; C_0603_1608Metric_Pad1.08x0.95mm_HandSolder
J5: FPC_40P_LCD_ILI9488; TE_4-1734839-0_1x40-1MP_P0.5mm_Horizontal
J11: Display_shield; PinHeader_2x13_P2.54mm_Vertical_SMD
R11, R12, R13: 220; R_0603_1608Metric_Pad0.98x0.95mm_HandSolder

Connections:
+3.3V: C18.2, C19.2, C20.1, J5.6, J5.7, J5.33, J11.1, J11.17; also elsewhere on the board
+5V: C22.1, J11.2, J11.4; also elsewhere on the board
/Display/Display_CS: J5.9, J11.24; also elsewhere on the board
Display_DC: J5.10, J11.18; also elsewhere on the board
Display_RST: J5.15, J11.22; also elsewhere on the board
Display_TP_CS: J11.26; also elsewhere on the board
Display_TP_IRQ: J11.11; also elsewhere on the board
unnamed: J5.34, R11.1
unnamed: J5.35, R12.1
unnamed: J5.36, R13.1
SPI_CLK: J5.11, J11.23; also elsewhere on the board
SPI_MISO: J11.21; also elsewhere on the board
SPI_MOSI: J5.13, J11.19; also elsewhere on the board

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
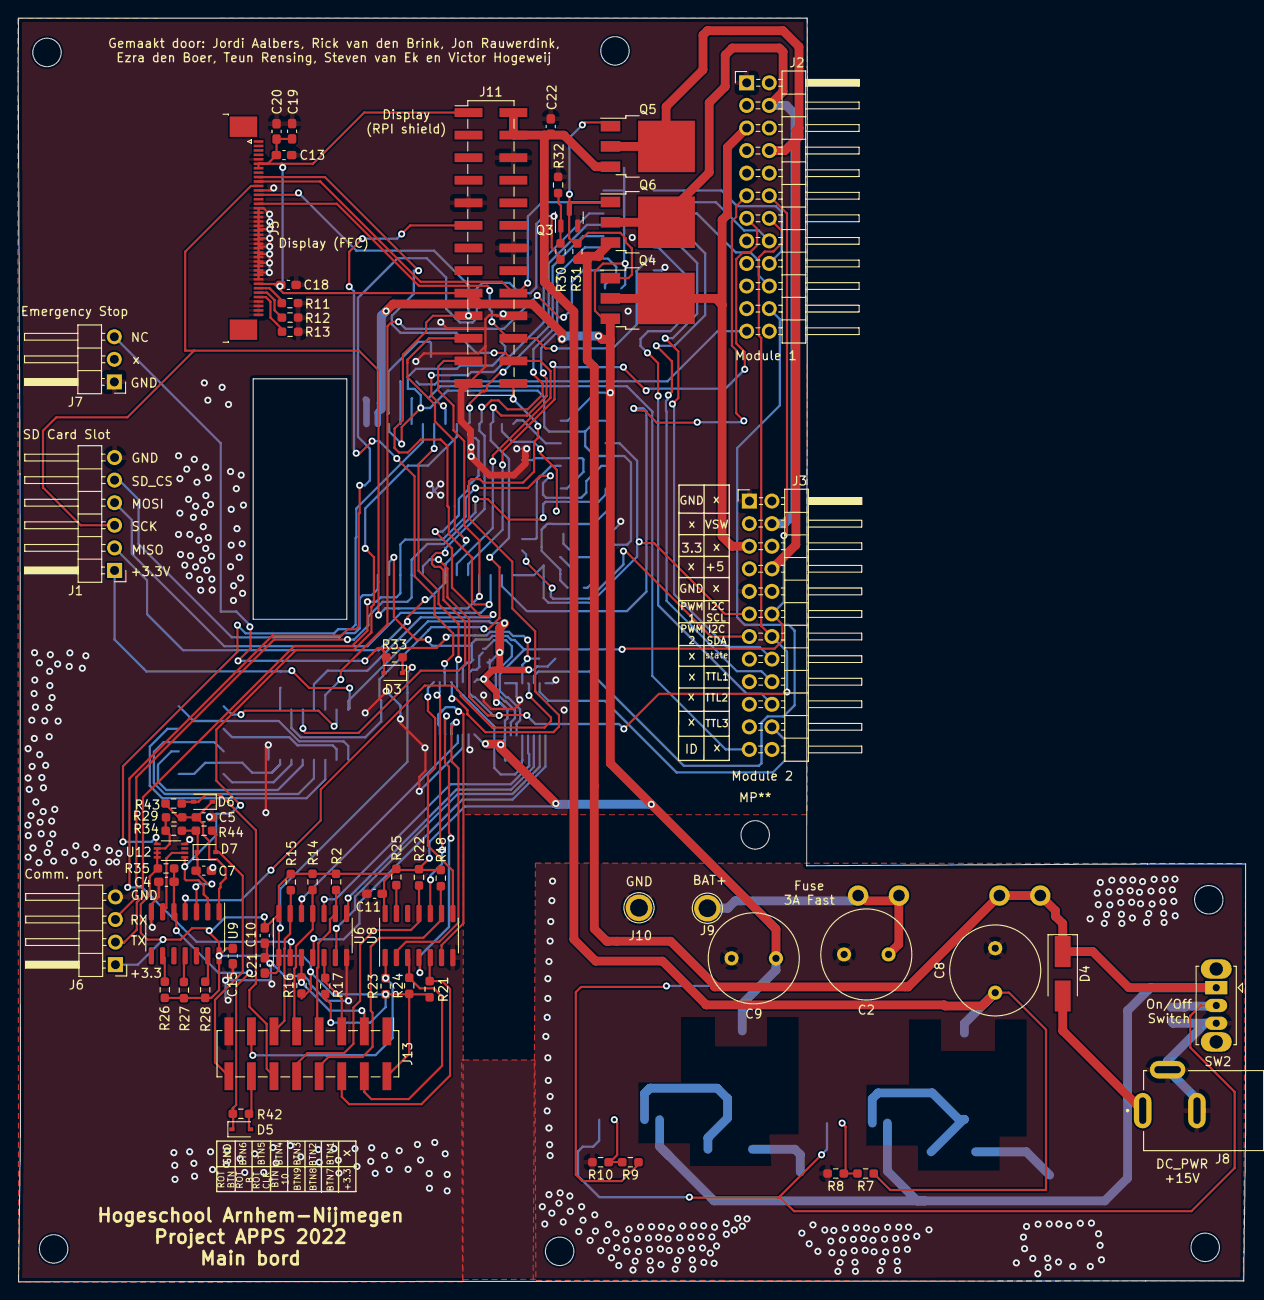
[picture p22: board Testapparaat.kicad_pcb from above]

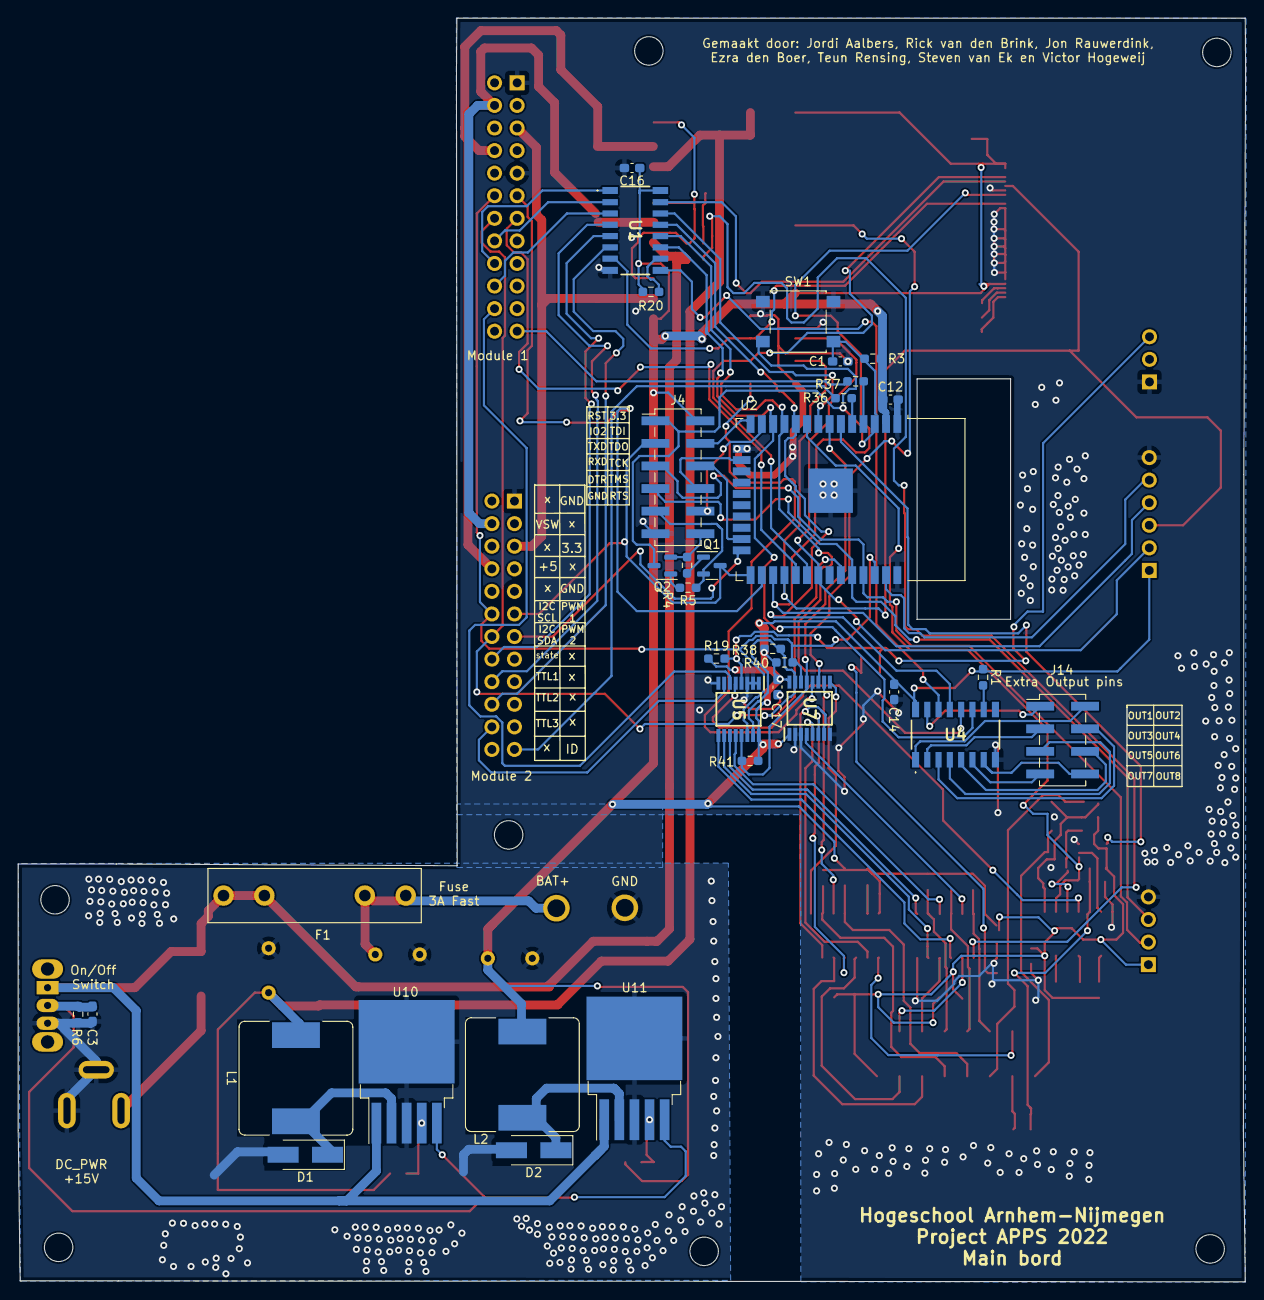
[picture p23: board Testapparaat.kicad_pcb from below]

Board: 2 copper layers, 138.1 x 142.2 mm, 107 parts (35 on the bottom side), 110 nets.

Other parts of the board:
MP**: MountingHole_3.2mm_M3
