teunrensing/APPS/(commit log)

2022-10-04 -add main_pcb files
    [MCU.kicad_sch, Power_Supply.kicad_sch, Testapparaat.kicad_pcb, Testapparaat.kicad_sch, display.kicad_sch, io_port.kicad_sch]
2022-10-04 -add hardware files for main pcb
    [MCU.kicad_sch, Power_Supply.kicad_sch, Testapparaat.kicad_pcb, Testapparaat.kicad_sch, display.kicad_sch, io_port.kicad_sch]
2022-10-04 -enh Made the schematic for the main unit almost complete :)
    [MCU.kicad_sch, Power_Supply.kicad_sch, Testapparaat.kicad_sch, display.kicad_sch, io_port.kicad_sch]
2022-10-17 -enh Noodstop is now hardware controlled
    [Power_Supply.kicad_sch, Testapparaat.csv, Testapparaat.kicad_sch]
2022-10-17 -enh made some changes to schematic and assigned fp
    [MCU.kicad_sch, Power_Supply.kicad_sch, Testapparaat.csv, Testapparaat.kicad_sch, display.kicad_sch, io_port.kicad_sch]
2022-10-18 -enh add seperate schematic and pcb for io ports/slots
    [CON-SOCJ-2155.step, D-Sub 6180xx211821.stp, MEM2051-00-195-00-A.stp, Power_Supply.kicad_sch, Testapparaat.kicad_pcb, Testapparaat.kicad_sch, Testapparaat_io.kicad_pcb, Testapparaat_io.kicad_sch]
2022-10-18 -add BOM
    [BOM Testapparaat.xlsx, GPIO_OUTPUTS.kicad_sch, MCU.kicad_sch, SN74AHC1G02DRLR.stp, Testapparaat.csv, Testapparaat.kicad_sch, Testapparaat_input.kicad_pcb, Testapparaat_input.kicad_sch]
2022-10-18 -enh made some changes to the bom
    [BOM Testapparaat.xlsx]
2022-10-19 -add bom and new schematic
    [BOM Testapparaat.xlsx, Power_Supply.kicad_sch, Testapparaat.kicad_sch, Testapparaat_input.csv, Testapparaat_input.kicad_sch, Testapparaat_io.csv]
2022-10-19 -enh Split up power section of main schematic
    [Testapparaat_voeding.kicad_pcb, Testapparaat_voeding.kicad_sch]
2022-11-08 -enh Changed the pinning of mcu, some were input-only pins
    [Testapparaat.kicad_sch]
2022-11-08 -enh Made a start at pcb design
    [MCU.kicad_sch, Power_Supply.kicad_sch, Testapparaat.kicad_pcb, Testapparaat.kicad_sch, button_inputs.kicad_sch, display.kicad_sch]
2022-11-09 -add Layout zo goed als af
    [Testapparaat.kicad_pcb]
2022-11-10 -enh PCB routed power section
    [Testapparaat.kicad_pcb]
2022-11-10 -add 3d models for connectors and SR
    [74HC595D-Q100,118.stp, F32Q-1A7H1-11040.stp]
2022-11-10 -enh First look at layout, proposed it to the team
    [74HC14D,653.stp, Power_Supply.kicad_sch, TCA9534PWR.stp, Testapparaat.kicad_pcb, Testapparaat.kicad_sch, srr1260.stp]
2022-11-15 -enh change slave address of second io expander
    [Testapparaat.kicad_pcb, Testapparaat.kicad_sch]
2022-11-15 -enh New pcb layout, may fit better in the existing case design
    [Testapparaat.kicad_pcb]
2022-11-15 -enh pcb layout rev2
    [Testapparaat.kicad_pcb]
2022-11-16 -enh component placing done:)
    [Testapparaat.kicad_pcb]
2022-11-16 -enh routed power section
    [Testapparaat.kicad_pcb]
2022-11-16 -enh routed more power section
    [Testapparaat.kicad_pcb]
2022-11-17 -enh routed some of the module traces
    [Testapparaat.kicad_pcb]
2022-11-20 -enh more routing
    [Testapparaat.kicad_pcb, Testapparaat.kicad_sch]
2022-11-20 -enh Routed most of the module sections
    [Testapparaat.kicad_pcb, Testapparaat.kicad_sch]
2022-11-20 -enh Routed jtag interface and most of pwm lines modules
    [Testapparaat.kicad_pcb]
2022-11-21 -enh Routed everything
    [Testapparaat.kicad_pcb]
2022-11-21 -enh drc check
    [Power_Supply.kicad_sch, Testapparaat.kicad_pcb, Testapparaat.kicad_sch]
2022-11-22 -enh drc
    [Testapparaat.kicad_pcb]
2022-11-22 -enh More drc
    [Testapparaat.kicad_pcb]
2022-11-22 -enh Fixed almost all warnings drc
    [Testapparaat.kicad_pcb]
2022-11-22 -add PDF schematic new rev
2022-11-22 -add Silkscreen pinouts of headers
    [Testapparaat.kicad_pcb]
2022-11-22 -add gerbers and minor improvements
    [Testapparaat-B_Cu.gbl, Testapparaat-B_Mask.gbs, Testapparaat-B_Paste.gbp, Testapparaat-B_Silkscreen.gbo, Testapparaat-Edge_Cuts.gm1, Testapparaat-F_Cu.gtl, Testapparaat-F_Mask.gts, Testapparaat-F_Paste.gtp]
2022-11-22 -enh Final adjustments
    [Testapparaat-B_Cu.gbl, Testapparaat-B_Mask.gbs, Testapparaat-B_Paste.gbp, Testapparaat-B_Silkscreen.gbo, Testapparaat-Edge_Cuts.gm1, Testapparaat-F_Cu.gtl, Testapparaat-F_Mask.gts, Testapparaat-F_Paste.gtp]
2022-11-22 -add new gerbers
2022-11-22 -add gerbers of IO pcb
    [Testapparaat_io-B_Cu.gbl, Testapparaat_io-B_Mask.gbs, Testapparaat_io-B_Paste.gbp, Testapparaat_io-B_Silkscreen.gbo, Testapparaat_io-Edge_Cuts.gm1, Testapparaat_io-F_Cu.gtl, Testapparaat_io-F_Mask.gts, Testapparaat_io-F_Paste.gtp]
2022-11-22 -enh new pdf schematic
